gkeeth/calbox/fab/pdf/calbox-F.Fab.pdf

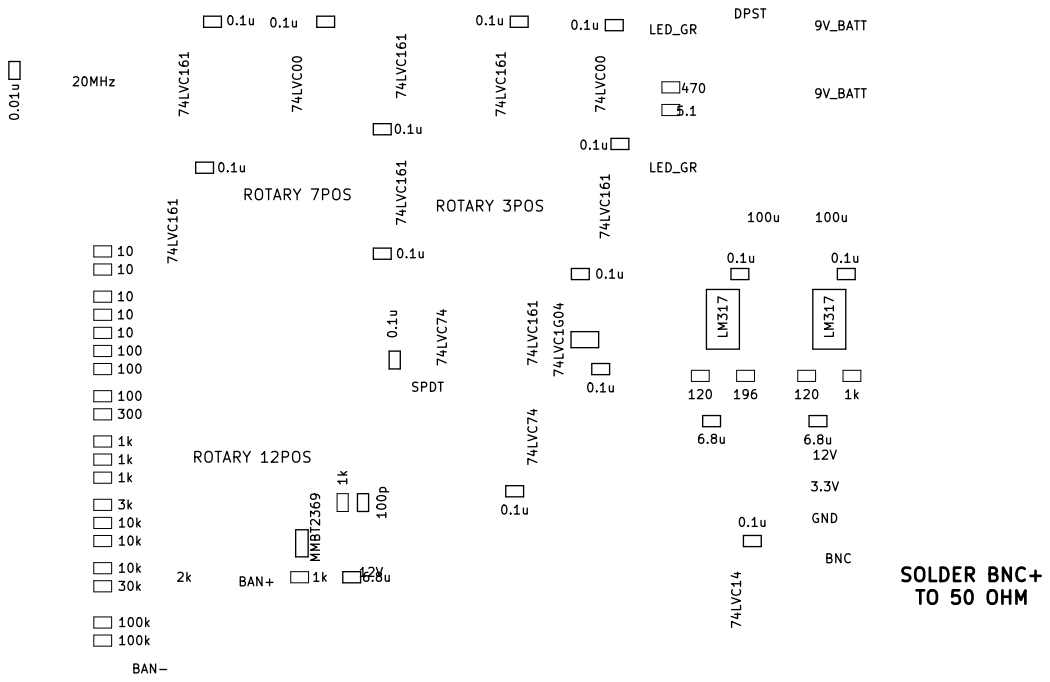
[picture p1: page 1]

File: calbox.kicad_pcb Sheet: SOLDER BNC+ TO 50 OHM
