gkeeth/calbox/doc/schem/calbox.pdf

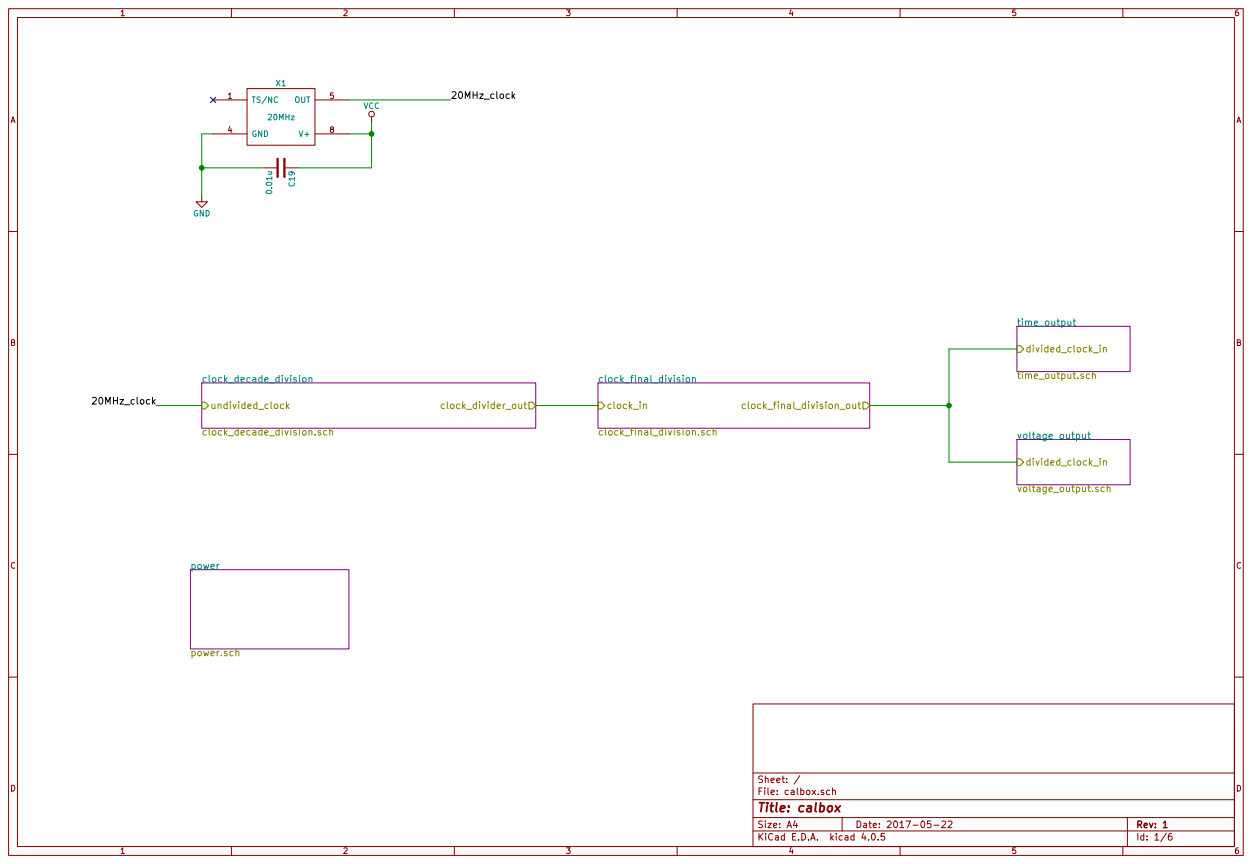
[picture p2: page 1]

File: calbox.sch Sheet: /
Id: 1/6 Title: calbox

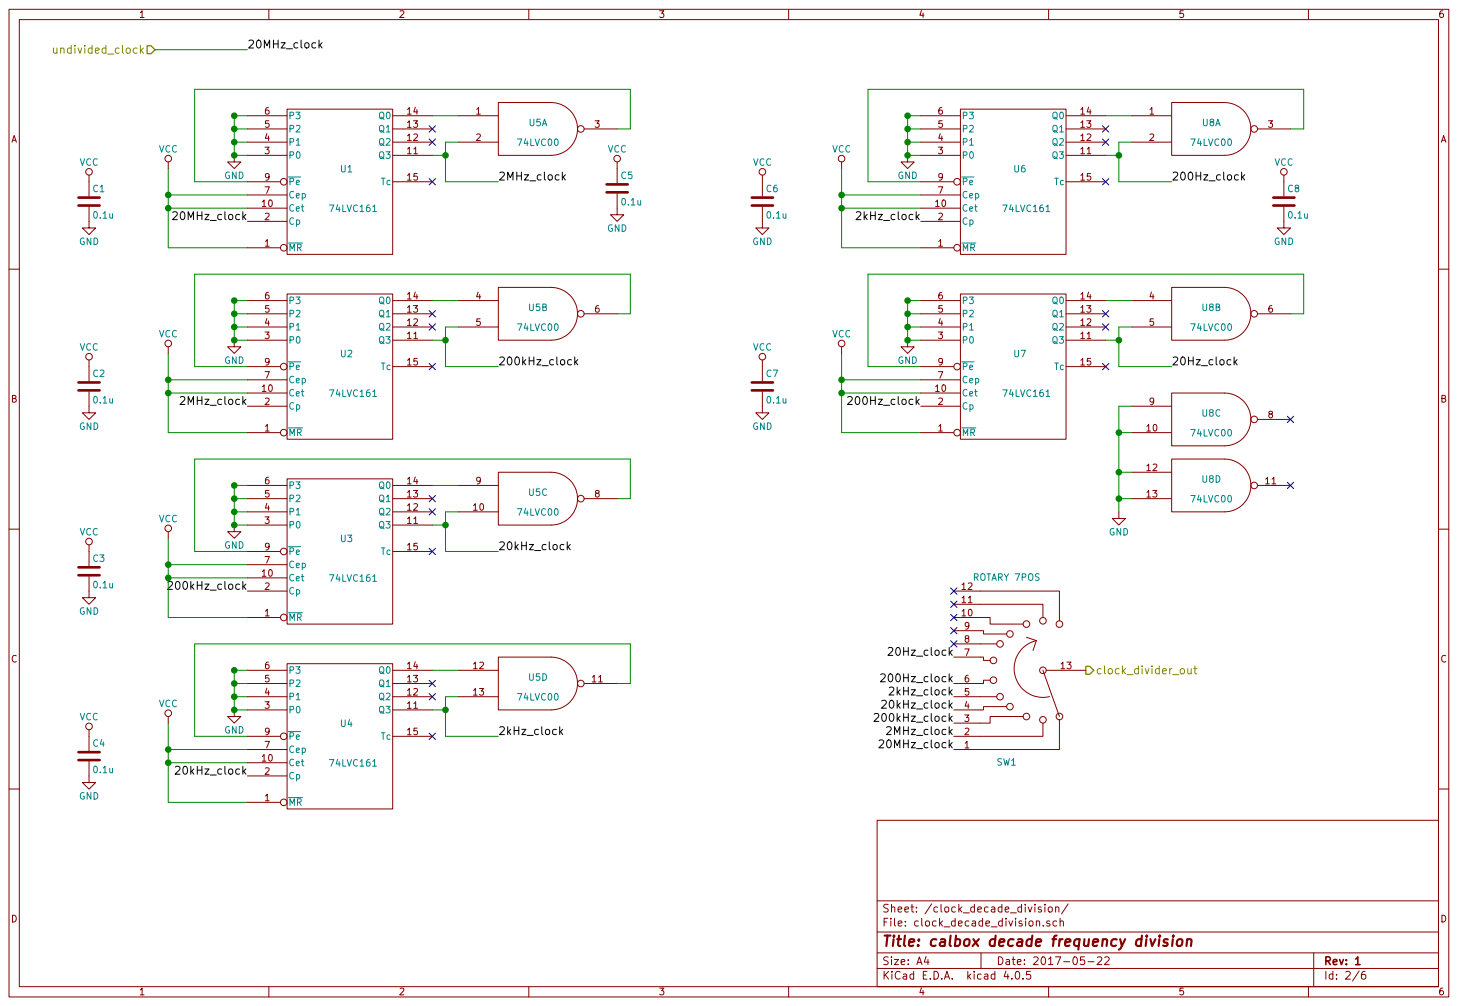
[picture p3: page 2]

Sheet: /clock_decade_division/
File: clock_decade_division.sch
Id: 2/6 Title: calbox decade frequency division

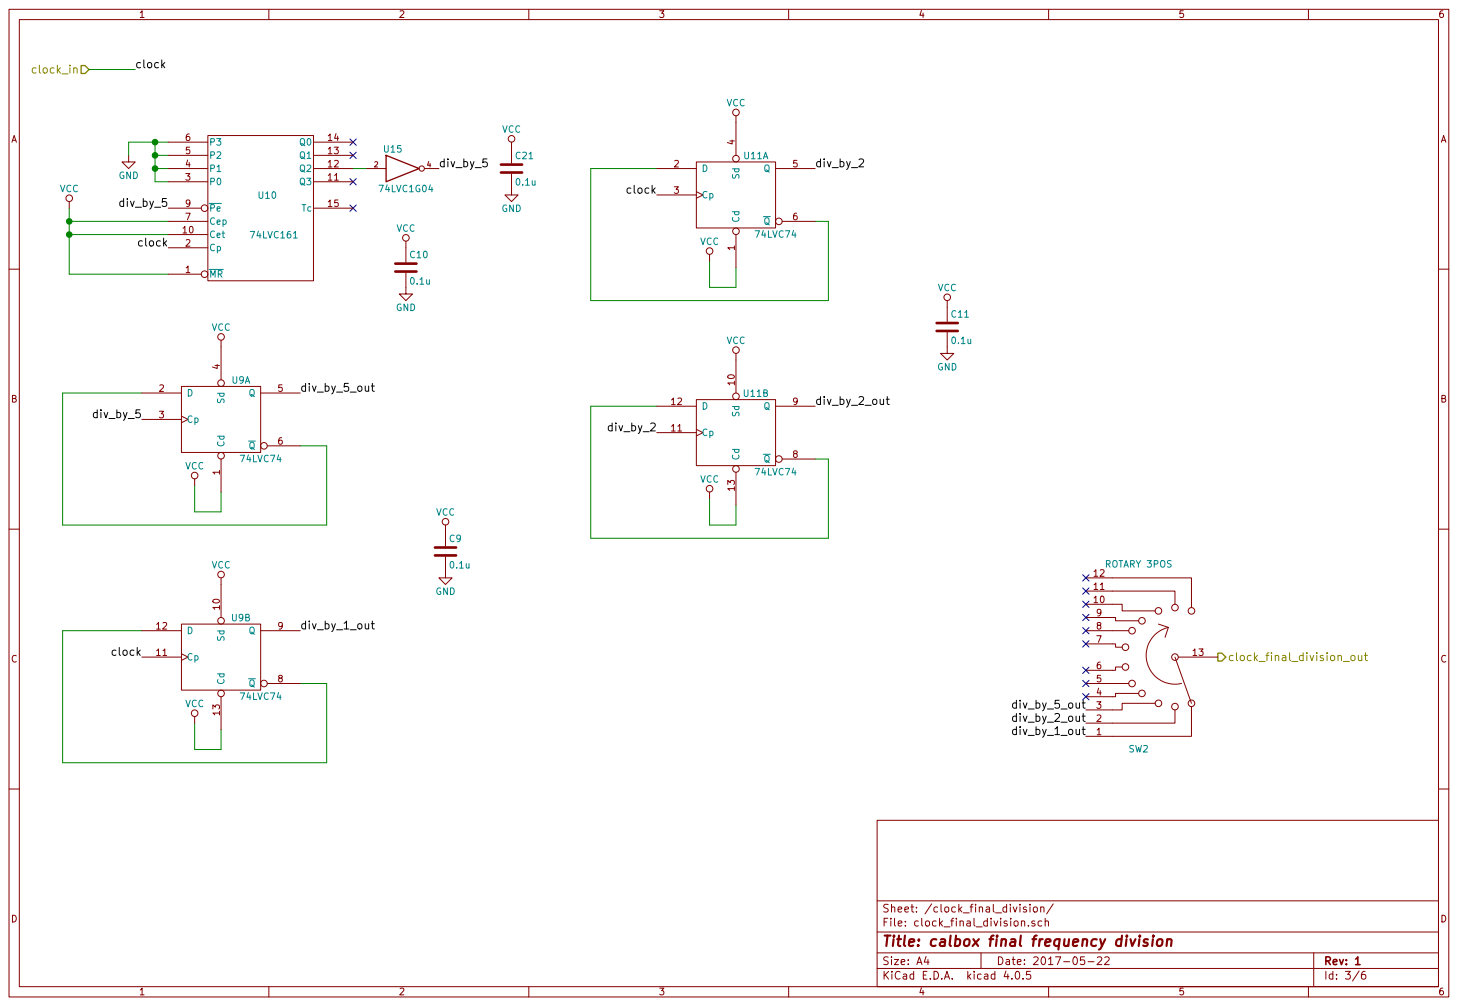
[picture p4: page 3]

Sheet: /clock_final_division/
File: clock_final_division.sch
Id: 3/6 Title: calbox final frequency division

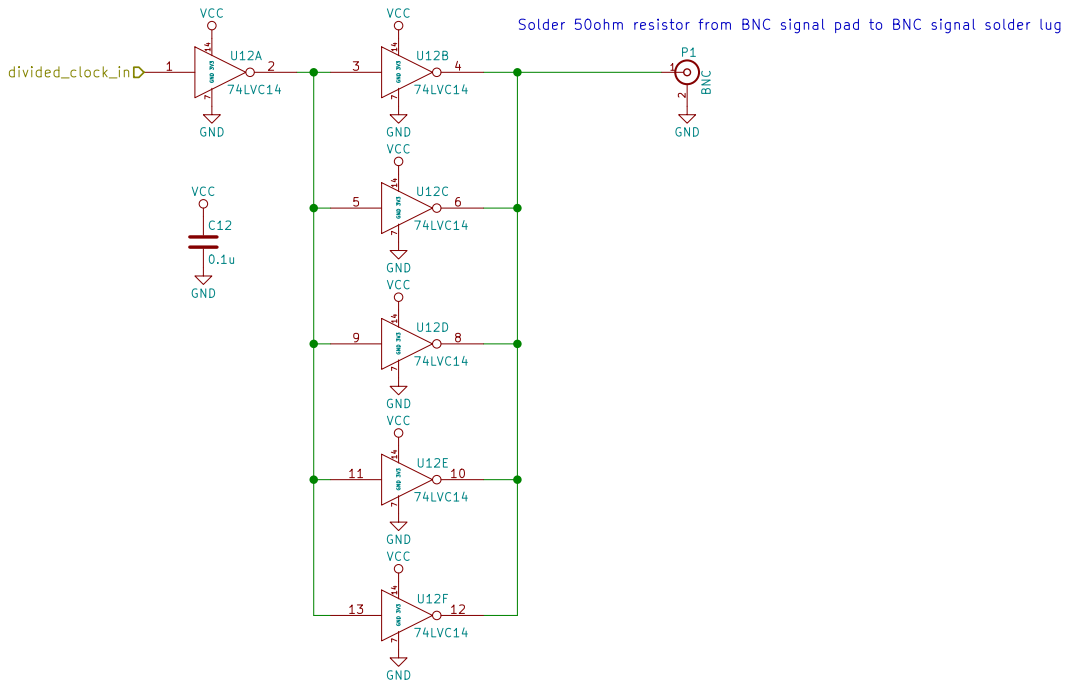
[picture p5: page 4]

Sheet: /time_output/
File: time_output.sch
Id: 4/6 Title: calbox time output

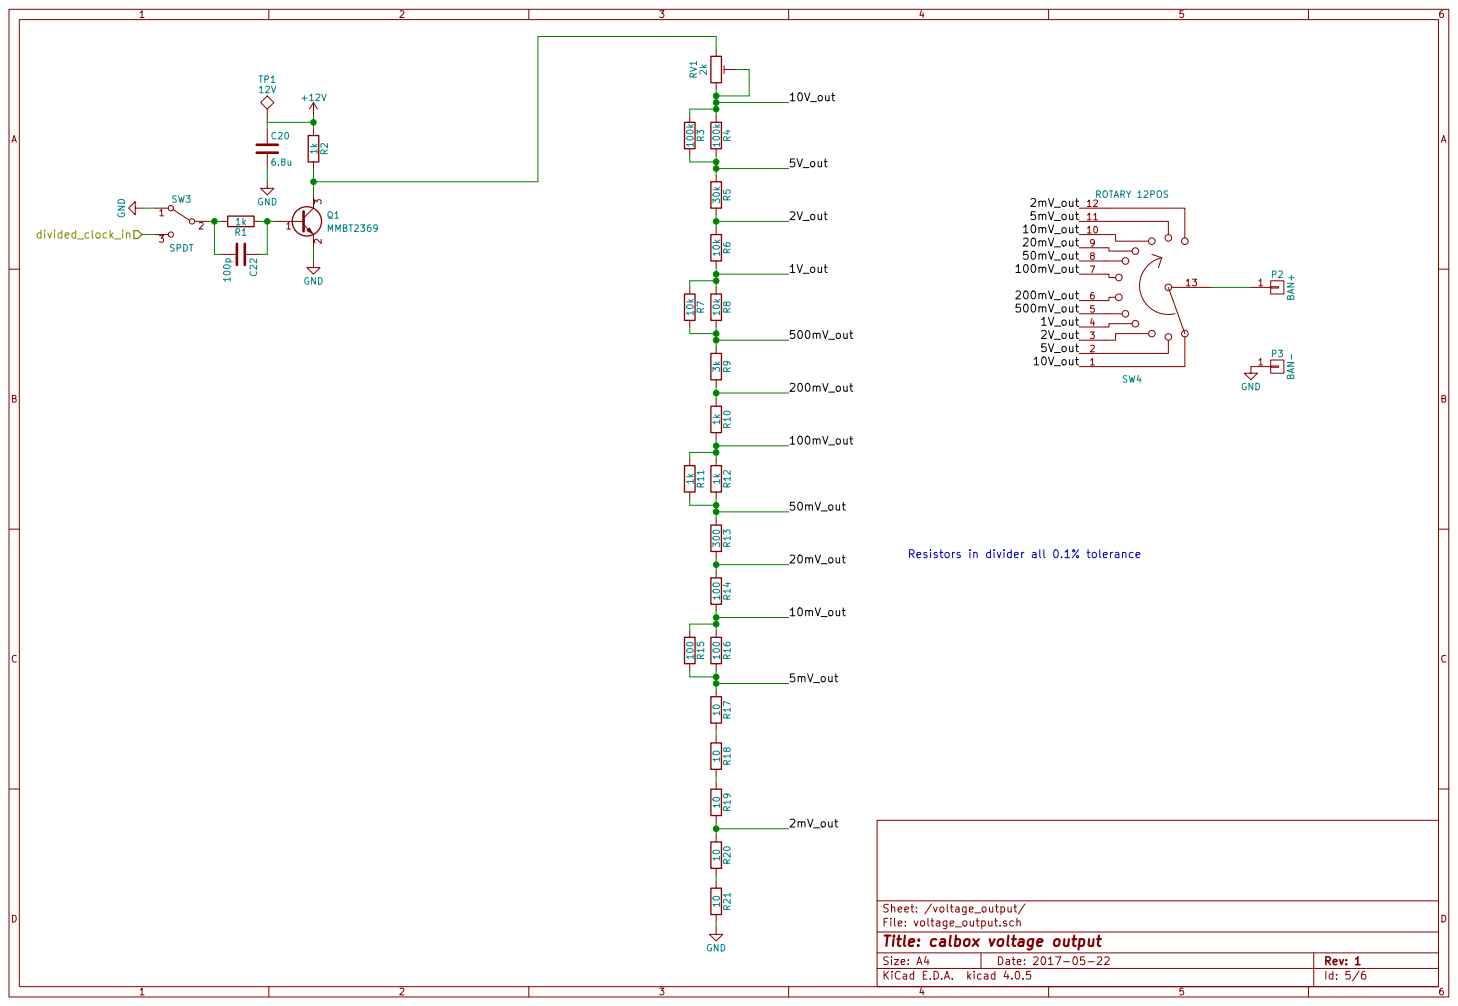
[picture p6: page 5]

File: voltage_output.sch
Id: 5/6 Title: calbox voltage output

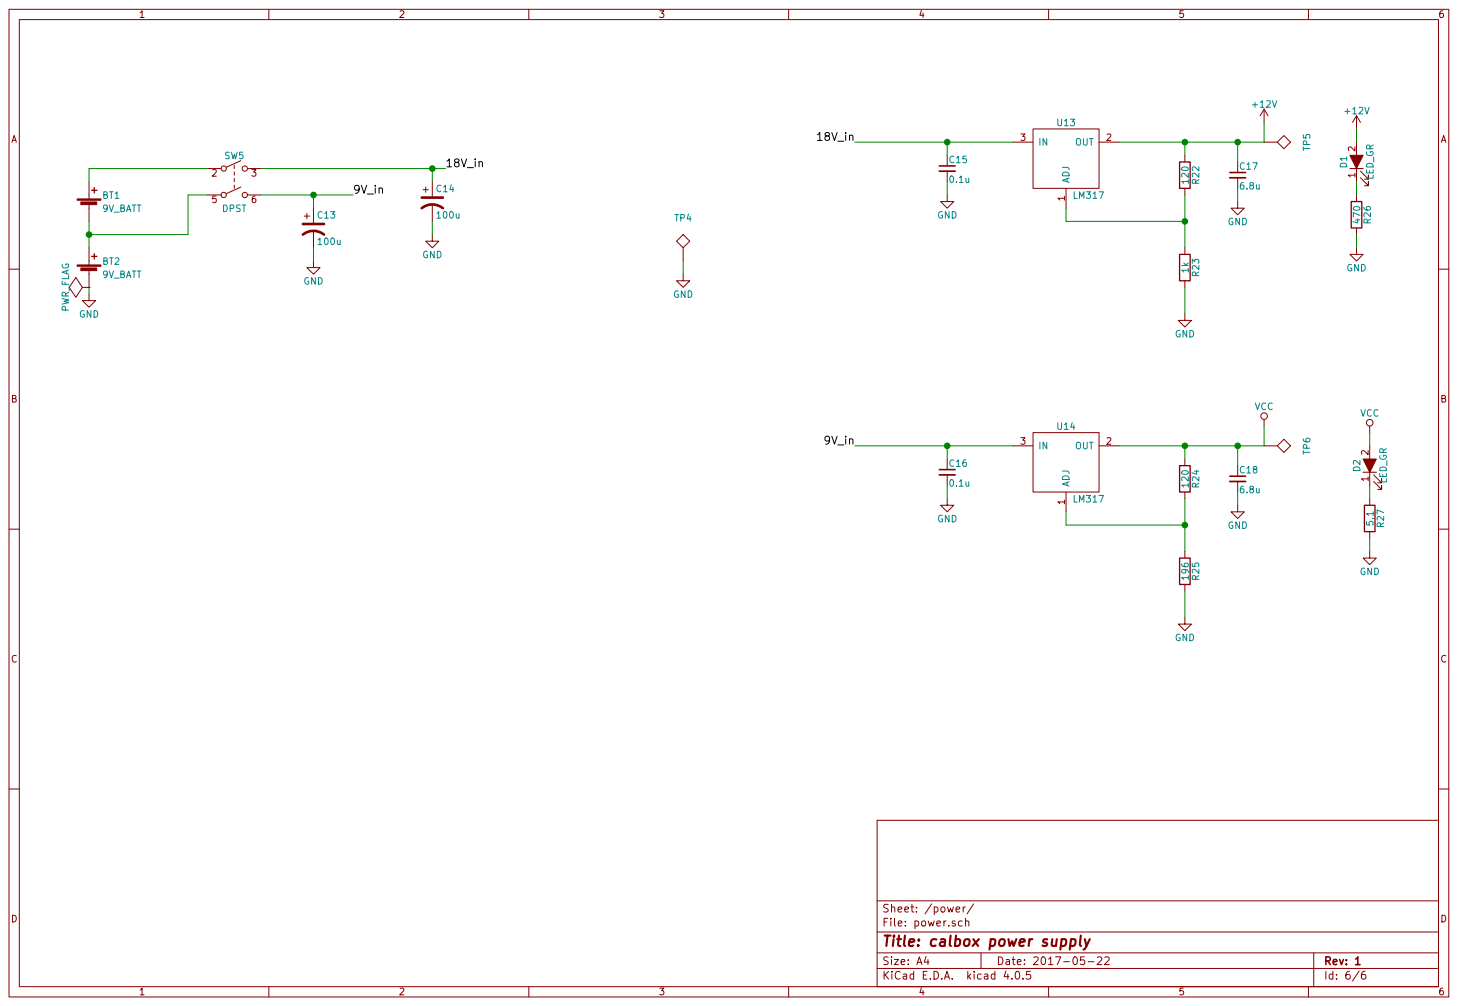
[picture p7: page 6]

Sheet: /power/
File: power.sch
Id: 6/6 Title: calbox power supply
