gkeeth/calbox/fab/pdf/calbox-B.Cu.pdf

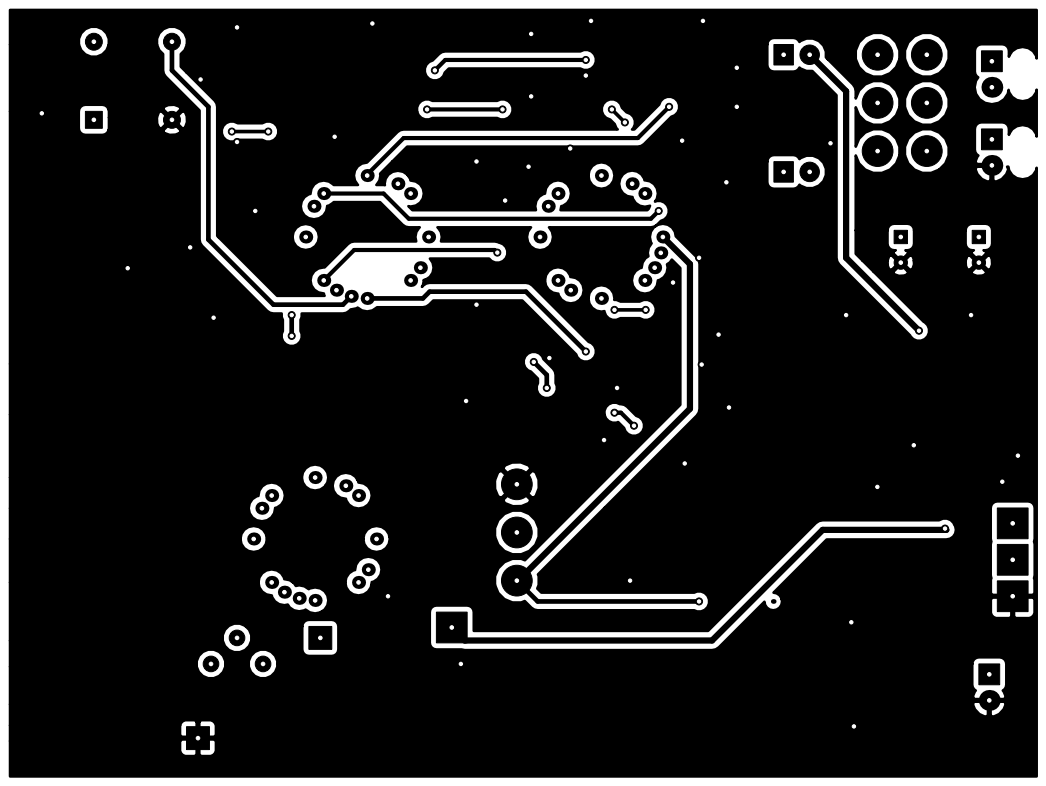
[picture p8: page 1]
