gkeeth/calbox/fab/pdf/calbox-B.Mask.pdf

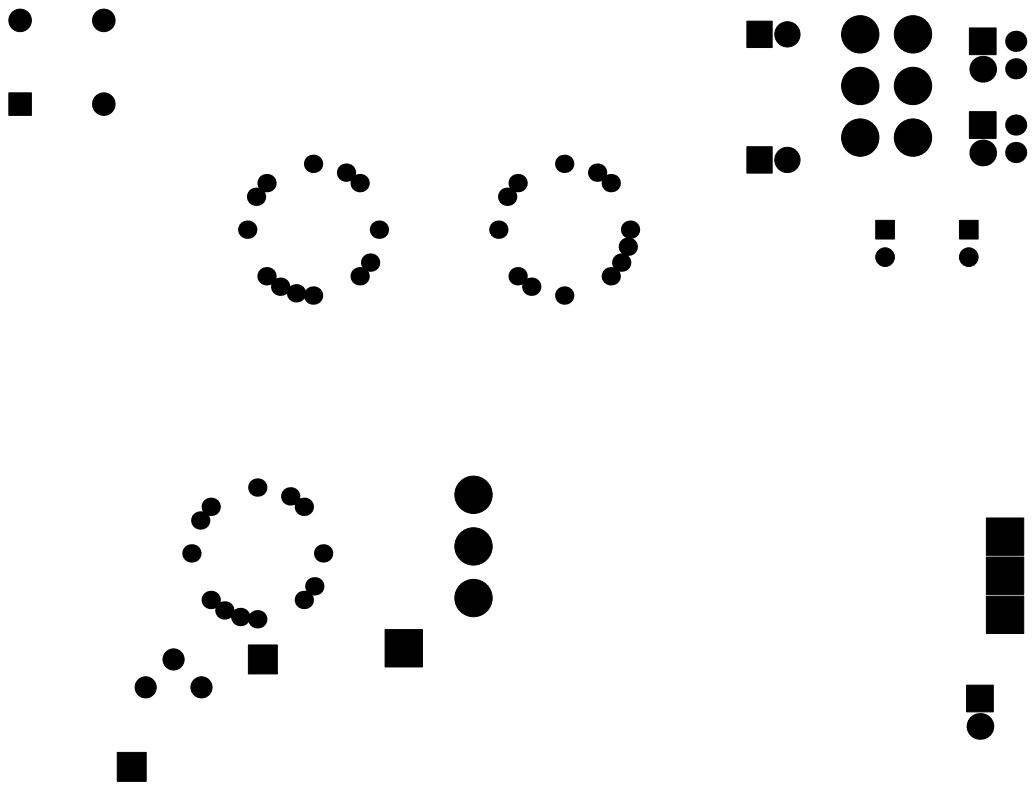
[picture p9: page 1]
