gkeeth/calbox/fab/pdf/calbox-Eco1.User.pdf

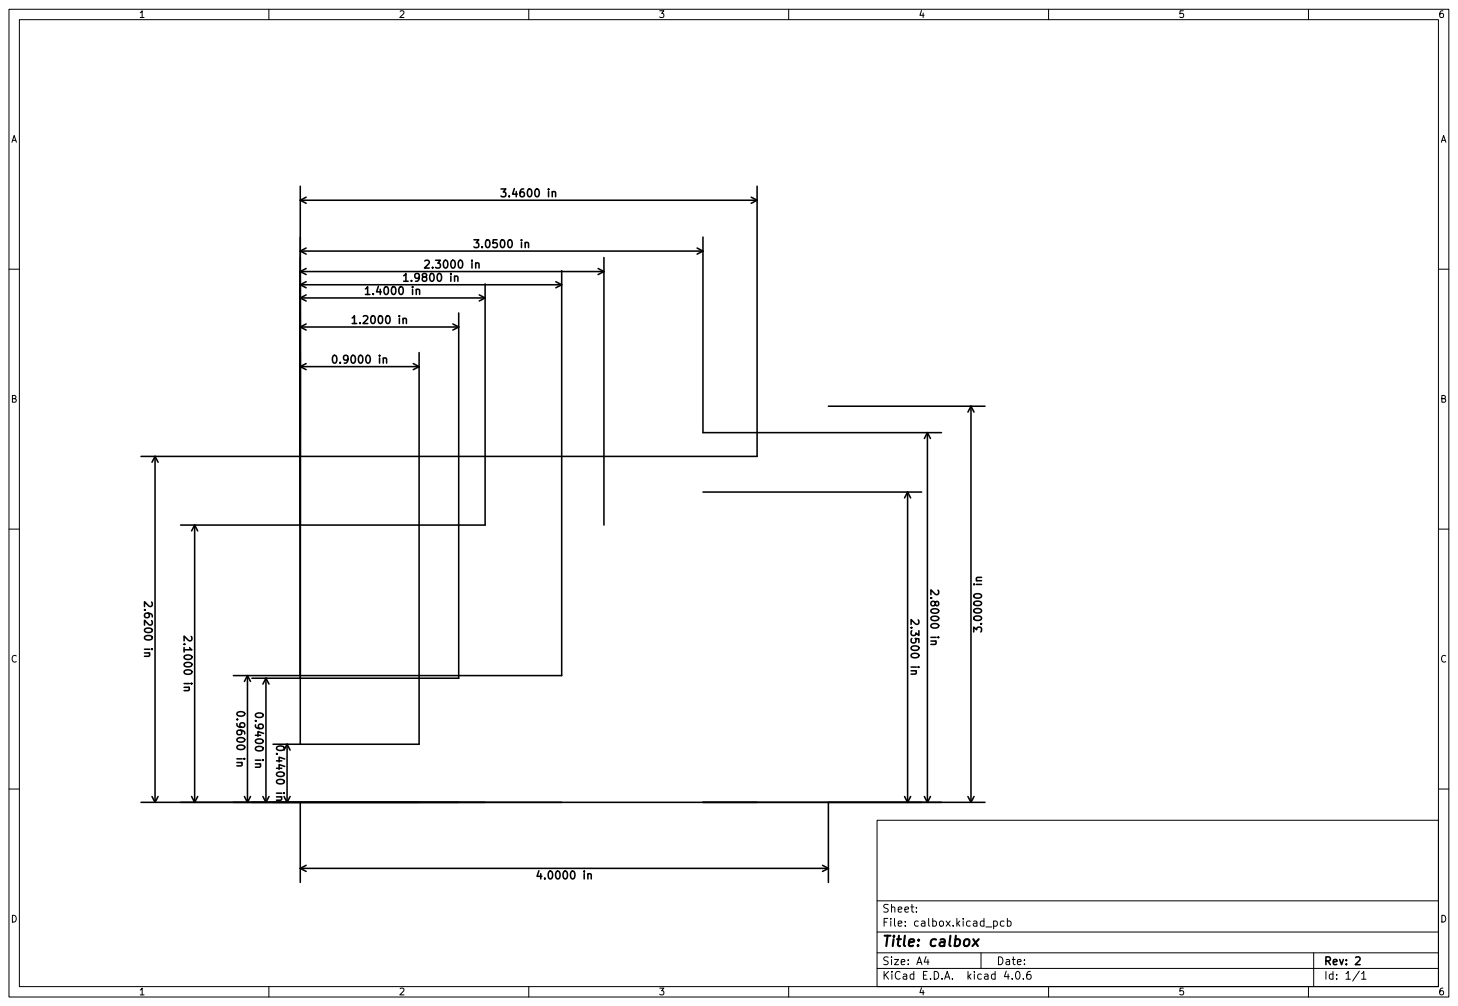
[picture p10: page 1]

1.9800 in
1.4000 in
