gkeeth/calbox/fab/pdf/calbox-Eco2.User.pdf

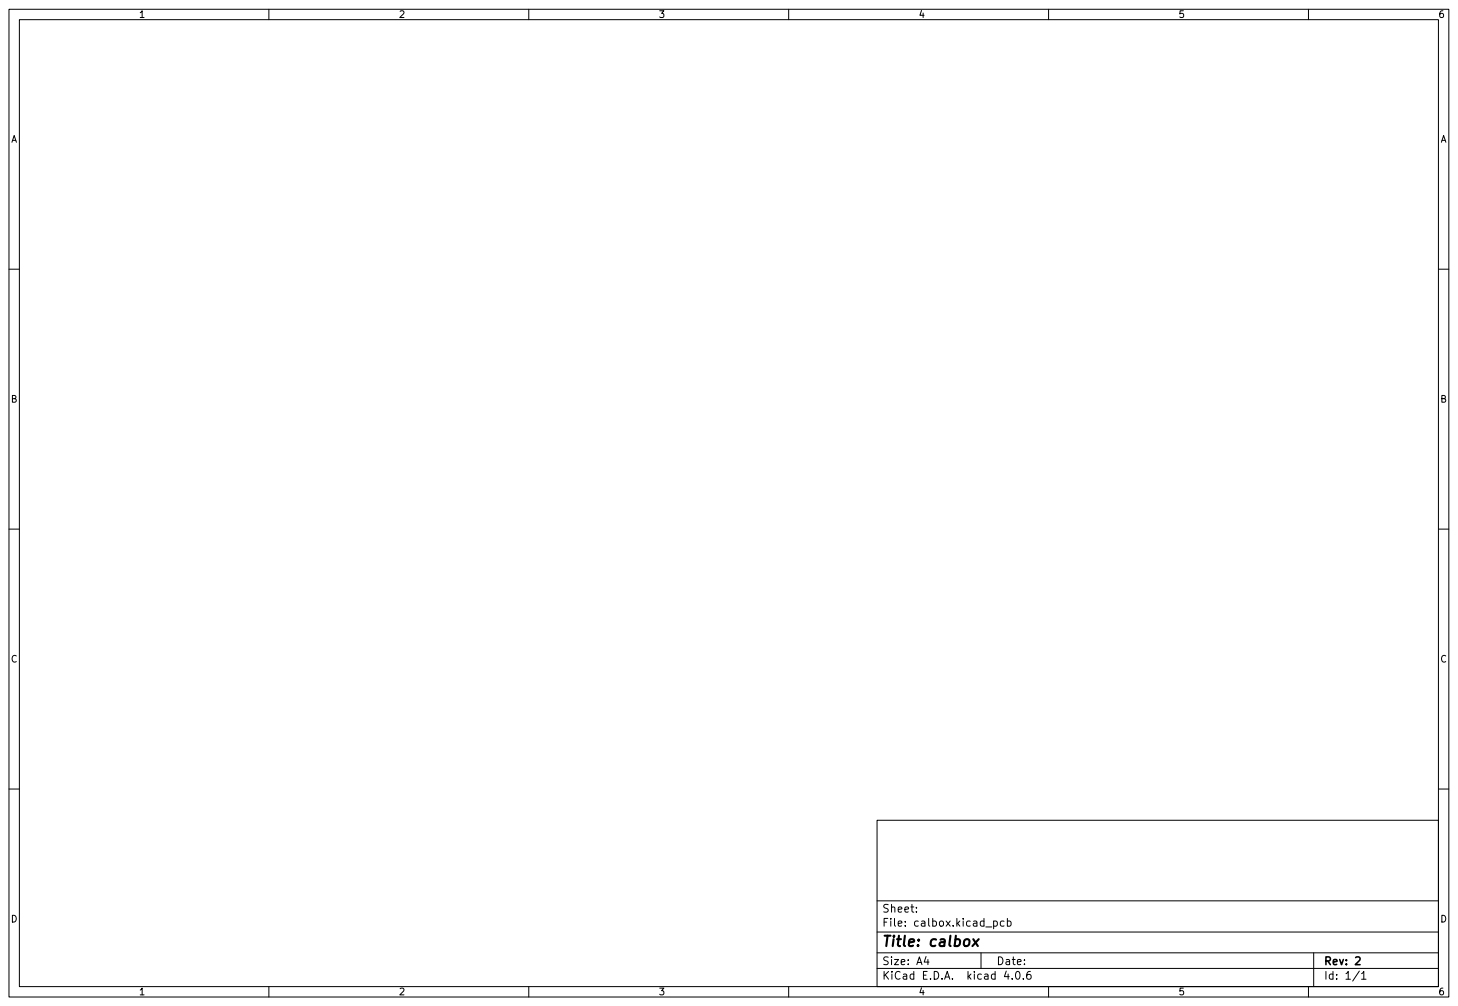
[picture p11: page 1]
