gkeeth/calbox/fab/pdf/calbox-Edge.Cuts.pdf

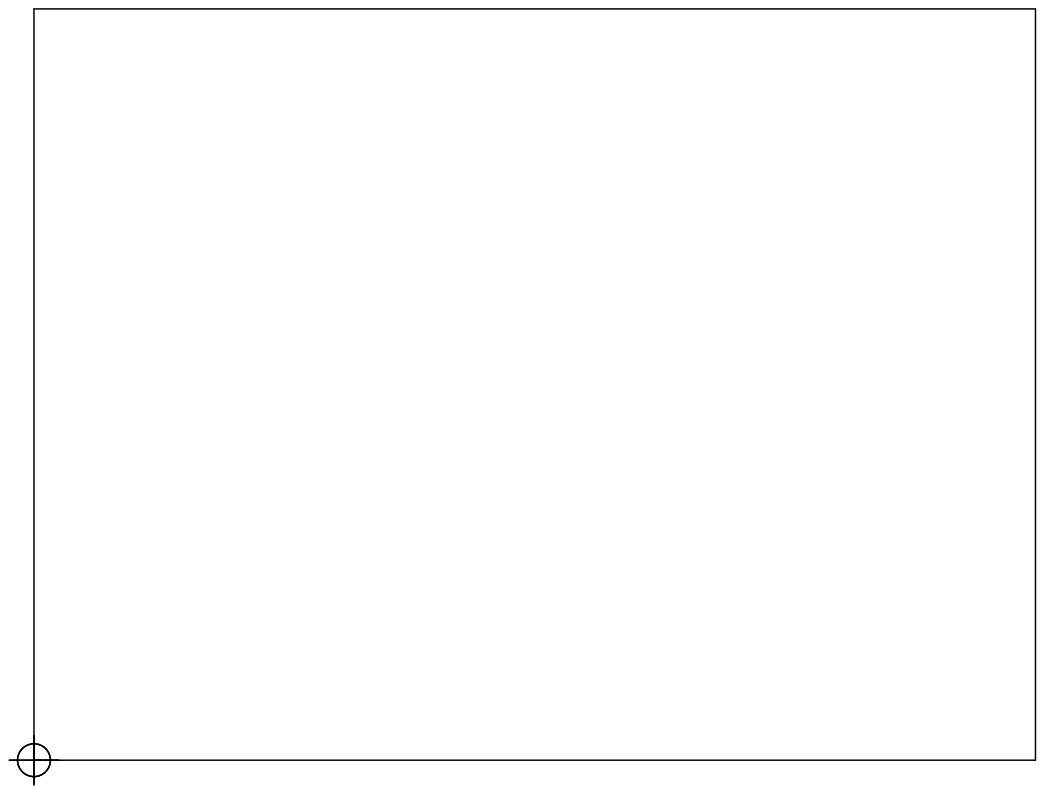
[picture p12: page 1]
