gkeeth/calbox/fab/pdf/calbox-F.Cu.pdf

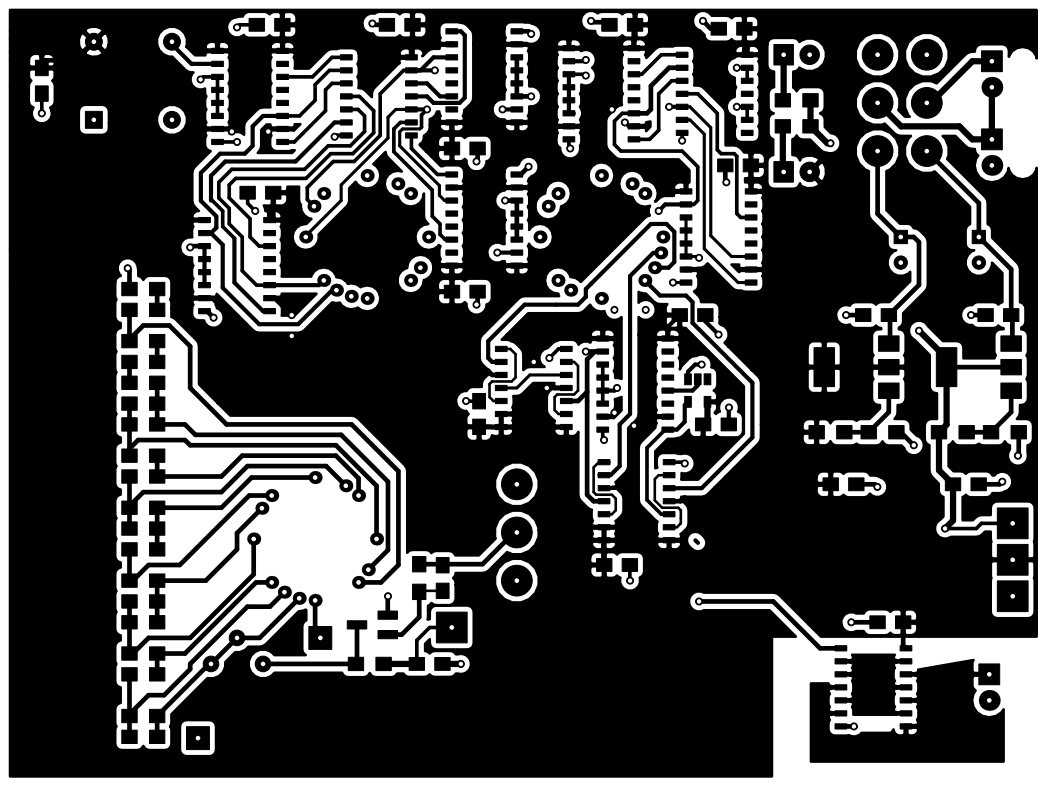
[picture p13: page 1]
