gkeeth/calbox/fab/pdf/calbox-F.Mask.pdf

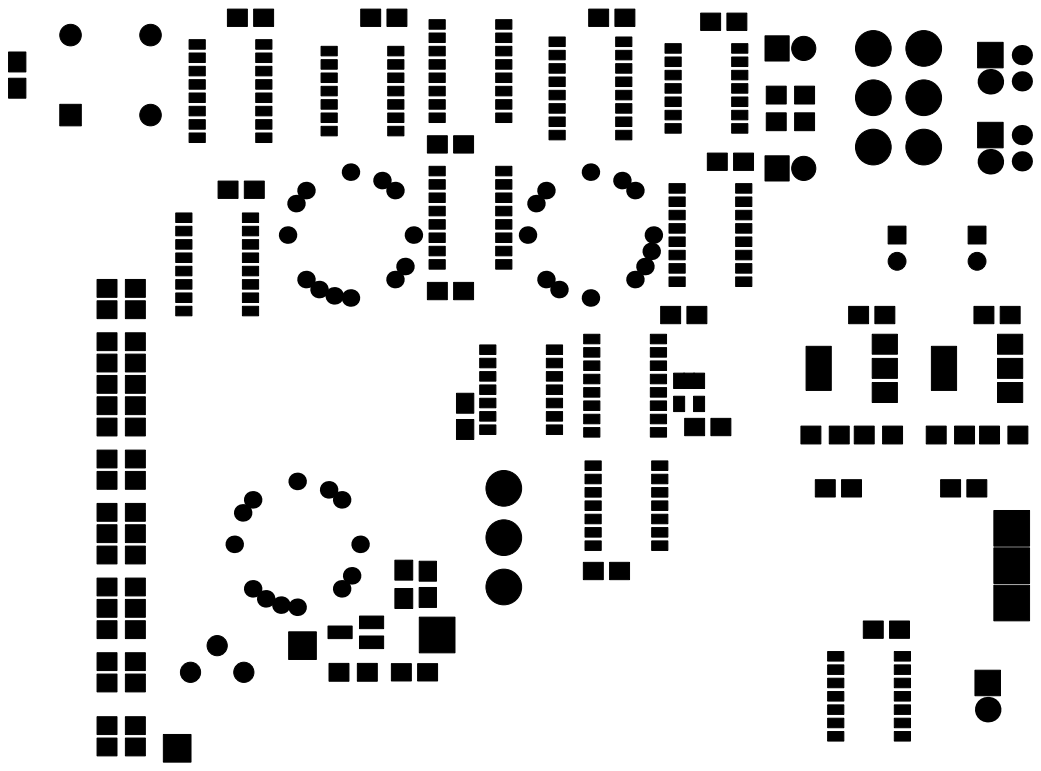
[picture p14: page 1]
