gkeeth/calbox/fab/pdf/calbox-F.SilkS.pdf

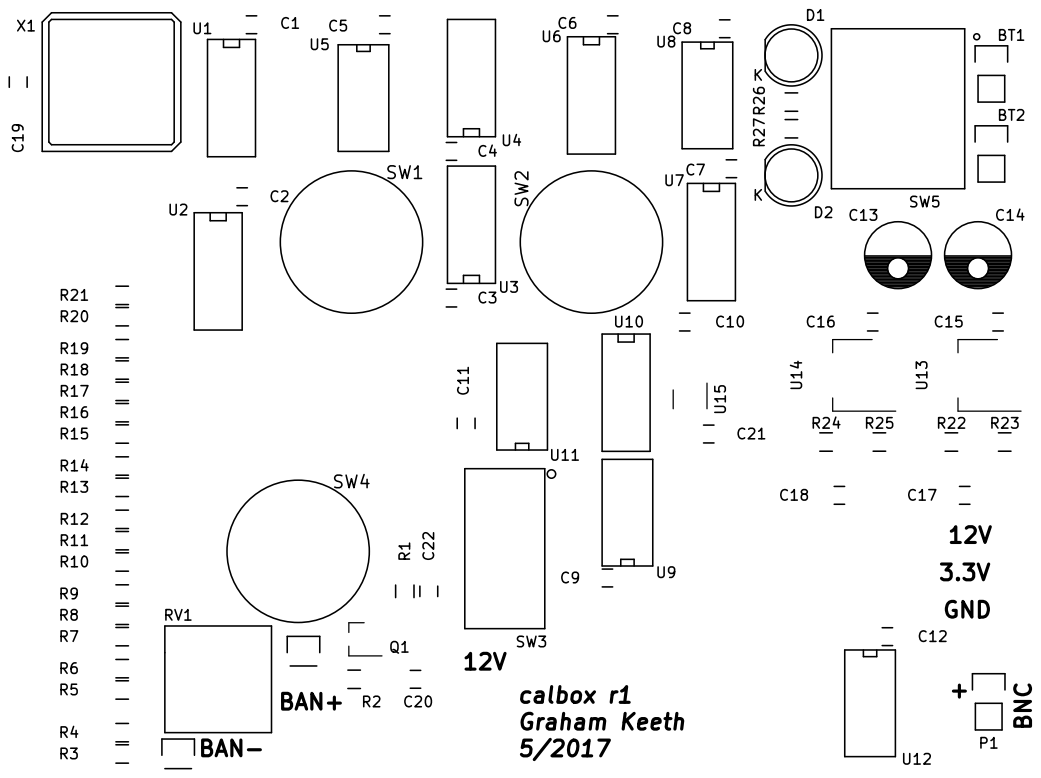
[picture p15: page 1]
