gkeeth/calbox/fab/pdf/calbox-Cmts.User.pdf

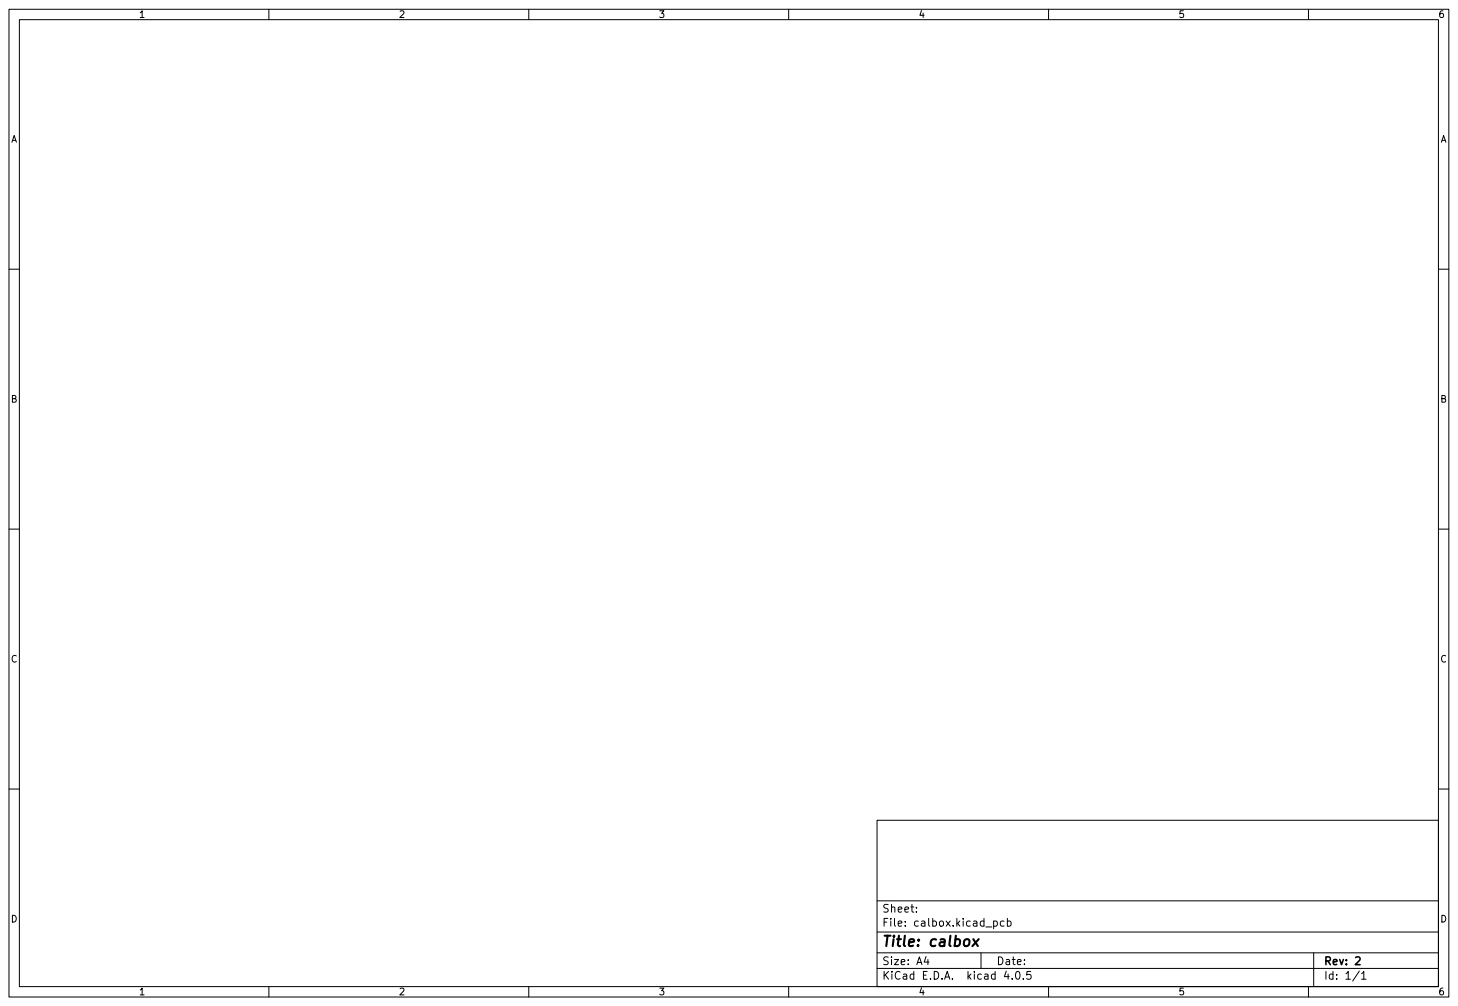
[picture p16: page 1]
