gkeeth/calbox/fab/pdf/calbox-F.CrtYd.pdf

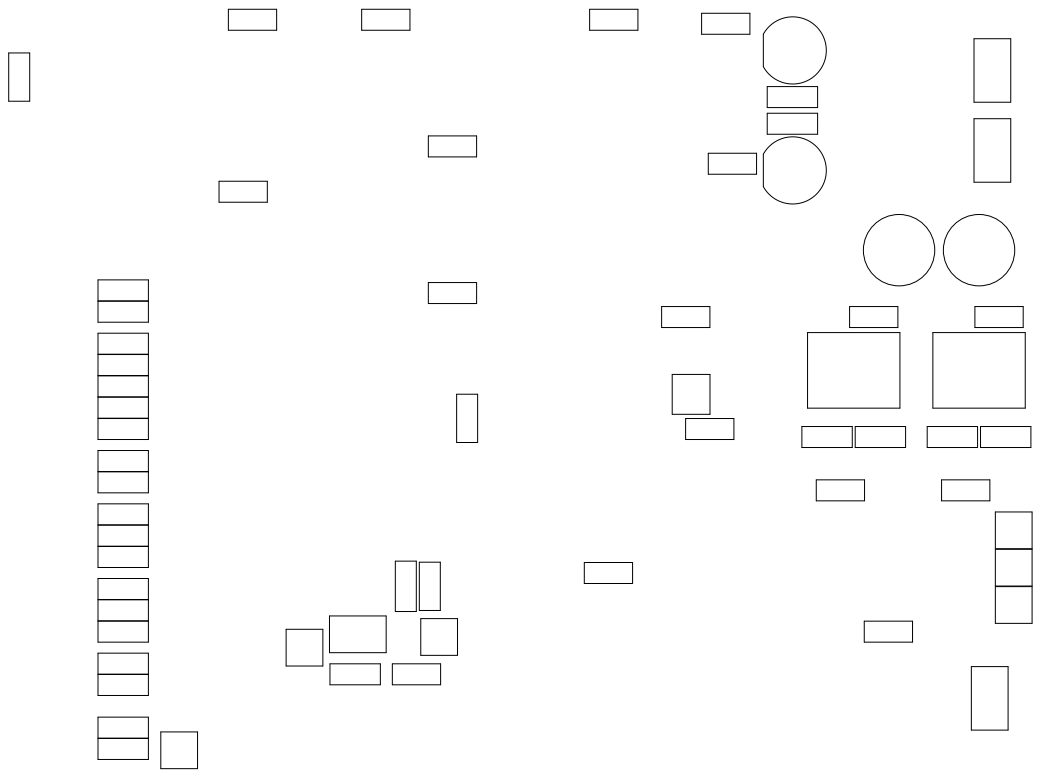
[picture p17: page 1]
