gkeeth/calbox/sim/freq_div.asc

U1: 74hct161
U2: 74hct04
V1: voltage; PULSE(0 3.3 0 1n 1n 24n 50n)
V2: voltage; 3.3
Named nets: 0, clk_20Meg, vcc, q2
.tran 10u
.inc 74hct.lib
