gkeeth/calbox/sim/voltage_output.asc

C1: cap; 6.8µ
C2: cap; 10p
C3: cap; 1p
C4: cap; 10p
C5: cap; 10p
C6: cap; 100p
C7: cap; 6.8µ
C8: cap; 100p
Q1: npn; 2N3904
Q2: npn; 2N2369
Q3: pnp; 2N3906
Q4: npn; 2N3904
Q5: npn; 2N3904
Q6: npn; 2N3904
Q7: npn; 2N3904
Q8: npn; 2N3904
Q9: npn; 2N3904
Q10: npn; 2N2369
Q11: npn; 2N3904
Q13: pnp; 2N3906
R1: res; 1k
R2: res; 50
R3: res; 30
R4: res; 10
R5: res; 5
R6: res; 3
R7: res; 2
R8: res; 1.1k
R9: res; 1k
R10: res; 1k
R11: res; 90k
R12: res; 9k
R13: res; 900
R14: res; 90
R15: res; 9
R16: res; 1
R17: res; 2.7k
R18: res; 100
R19: res; 1k
R20: res; 1k
R21: res; 90k
R22: res; 9k
R23: res; 900
R24: res; 90
R25: res; 9
R26: res; 1
R27: res; 5k
R28: res; 1k
R29: res; 1k
R30: res; 20
R31: res; 1k
R32: res; 90k
R33: res; 9k
R34: res; 900
R35: res; 90
R36: res; 9
R37: res; 1
R38: res; 2.7k
R39: res; 10k
R40: res; 470
R41: res; 90k
R42: res; 9k
R43: res; 900
R44: res; 90
R45: res; 9
R46: res; 1
R47: res; 7k
R48: res; 3k
R49: res; 1k
R50: res; 2k
R51: res; 100
R52: res; 300
R53: res; 5k
R54: res; 500
R55: res; 1k
R56: res; 3k
R57: res; 1k
R58: res; 1.1k
R59: res; 1k
R60: res; 100k
V1: voltage; 12.19
V2: voltage; PULSE(0 3.3 0 10n 10n 40n 100n)
V3: voltage; 16
V4: voltage; 16
V5: voltage; 16
V6: voltage; 16
V7: voltage; 12.19
Named nets: 0, clk, pushpull_out, 10V, schmitt_out, comparator_out, highside_out, 5V, 2V, 2mV, 5mV, 10mV, 20mV, 50mV, 100mV, 200mV, 500mV, 1V, 10V2
.tran 1300n
.step param CC list 1p 10p 100p 1n 10n
.step param RB list 100 500 1k 5k 10k
.step dec param Cspeedup 1p 1n 2
.step param Rbase list 10 50 100 500 1k
