gkeeth/calbox/calbox.kicad_pcb

## KiCad design calbox.kicad_pcb (2017-05-23)

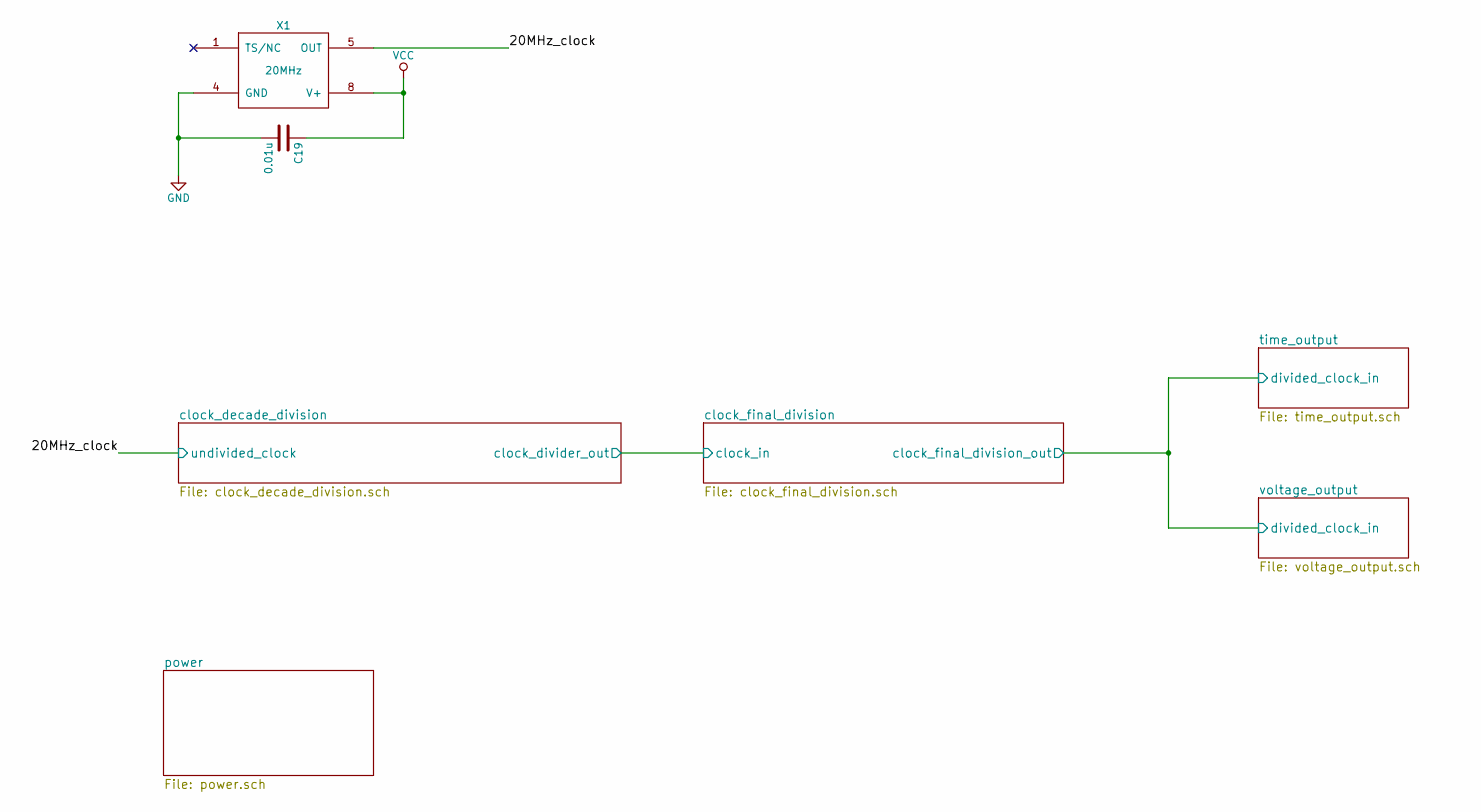
[picture p18: schematic calbox.sch]

Parts:
C19: 0.01u; C_0805_HandSoldering
X1: 20MHz; OSC_DIP8; Manufacturer PN ACHL-20.000MHZ-EK

Connections:
/20MHz_clock: X1.5 (OUT); also elsewhere on the board
GND: C19.2, X1.4 (GND); also elsewhere on the board
VCC: C19.1, X1.8 (V+); also elsewhere on the board

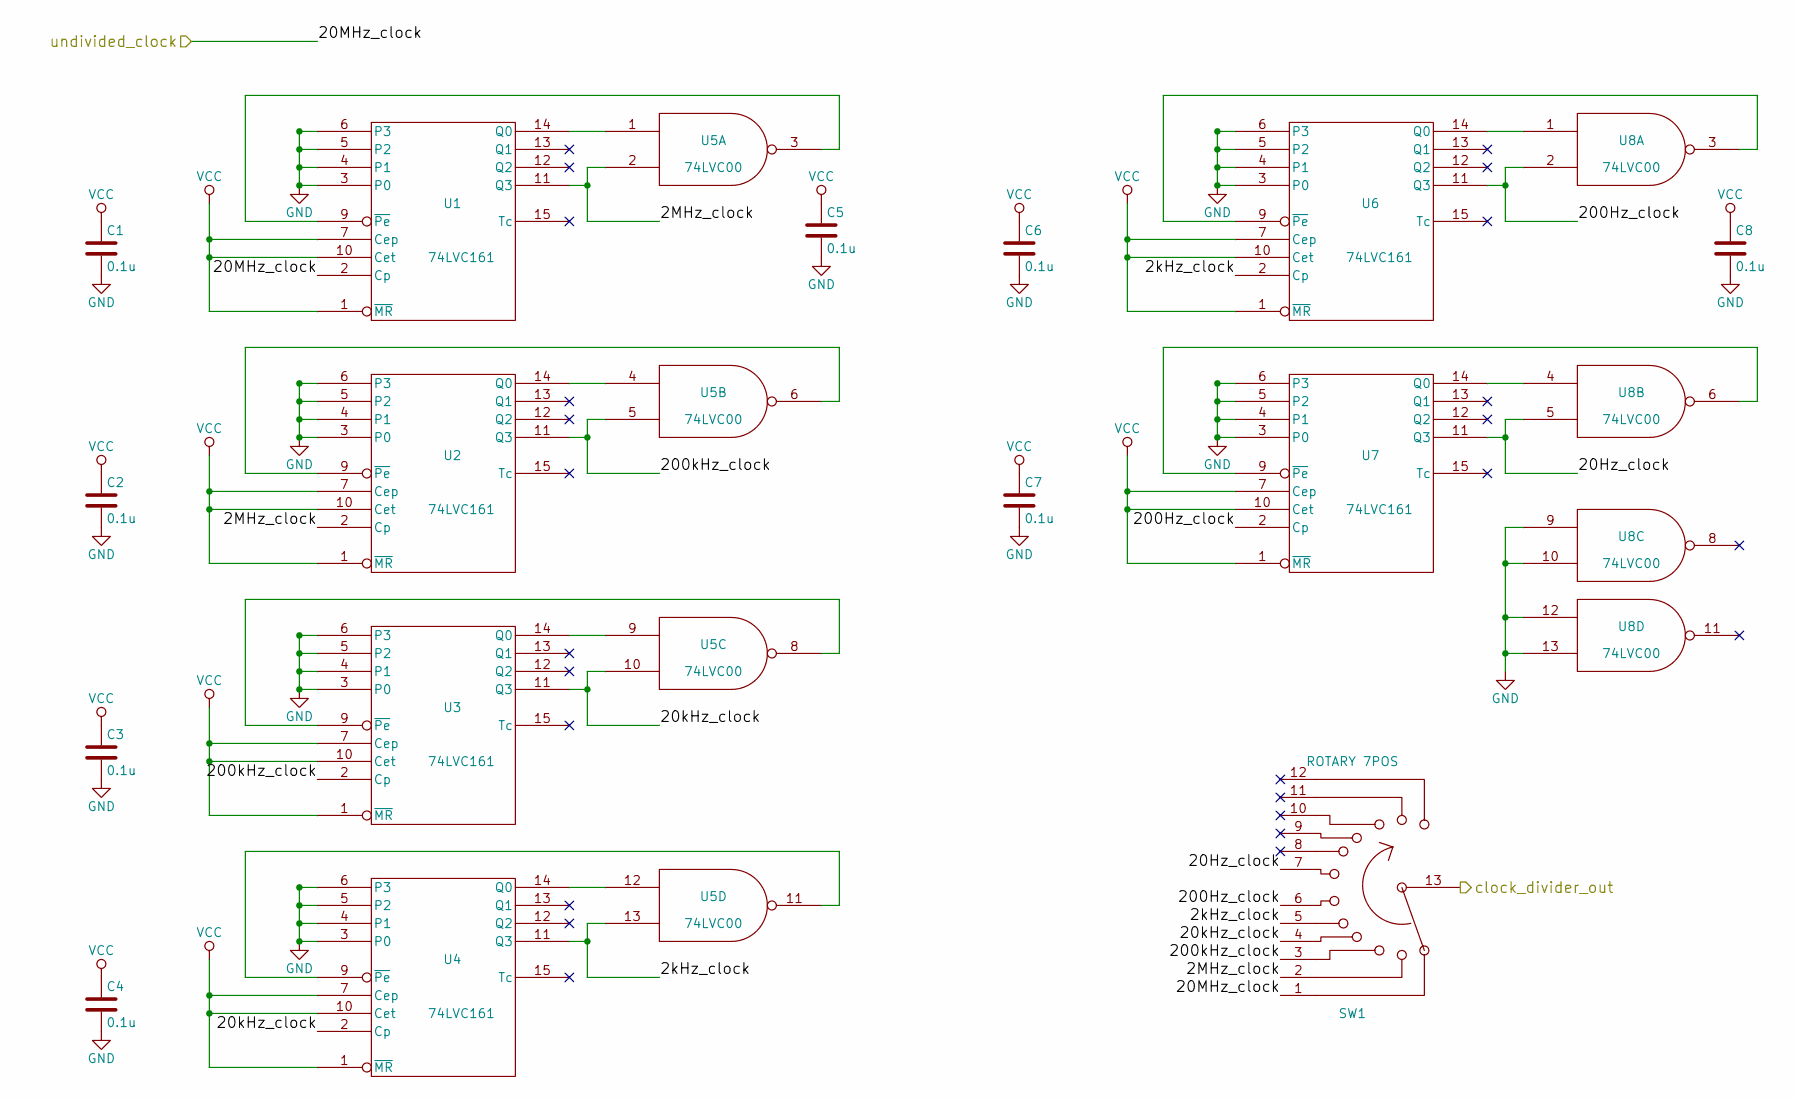
[picture p19: schematic clock_decade_division.sch, calbox decade frequency division]

Parts:
C1, C2, C3, C4, C5, C6, C7, C8: 0.1u; C_0805_HandSoldering
SW1: ROTARY 7POS; SW_ROTARY_SP12T_MRK112; Manufacturer PN MRK112-A
U1, U2, U3, U4, U6, U7: 74LVC161; SO-16-N; Manufacturer PN 4LVC161D118
U5, U8: 74LVC00; SOIC-14_N; Manufacturer PN SN74LVC00ADR

Connections:
/20MHz_clock: SW1.1, U1.2 (Cp); also elsewhere on the board
/clock_decade_division/2MHz_clock: SW1.2, U1.11 (Q3), U2.2 (Cp), U5.2
/clock_decade_division/2kHz_clock: SW1.5, U4.11 (Q3), U5.13, U6.2 (Cp)
/clock_decade_division/20Hz_clock: SW1.7, U7.11 (Q3), U8.5
/clock_decade_division/20kHz_clock: SW1.4, U3.11 (Q3), U4.2 (Cp), U5.10
/clock_decade_division/200Hz_clock: SW1.6, U6.11 (Q3), U7.2 (Cp), U8.2
/clock_decade_division/200kHz_clock: SW1.3, U2.11 (Q3), U3.2 (Cp), U5.5
/clock_decade_division/clock_divider_out: SW1.13; also elsewhere on the board
GND: C1.2, C2.2, C3.2, C4.2, C5.2, C6.2, C7.2, C8.2, U1.3 (P0), U1.4 (P1), U1.5 (P2), U1.6 (P3), U1.8 (GND), U2.3 (P0), U2.4 (P1), U2.5 (P2), U2.6 (P3), U2.8 (GND), U3.3 (P0), U3.4 (P1), U3.5 (P2), U3.6 (P3), U3.8 (GND), U4.3 (P0), U4.4 (P1), U4.5 (P2), U4.6 (P3), U4.8 (GND), U5.7 (GND), U6.3 (P0), U6.4 (P1), U6.5 (P2), U6.6 (P3), U6.8 (GND), U7.3 (P0), U7.4 (P1), U7.5 (P2), U7.6 (P3), U7.8 (GND), U8.7 (GND), U8.9, U8.10, U8.12, U8.13; also elsewhere on the board
unnamed: U1.9 (~Pe), U5.3
unnamed: U1.14 (Q0), U5.1
unnamed: U2.9 (~Pe), U5.6
unnamed: U2.14 (Q0), U5.4
unnamed: U3.9 (~Pe), U5.8
unnamed: U3.14 (Q0), U5.9
unnamed: U4.9 (~Pe), U5.11
unnamed: U4.14 (Q0), U5.12
unnamed: U6.9 (~Pe), U8.3
unnamed: U6.14 (Q0), U8.1
unnamed: U7.9 (~Pe), U8.6
unnamed: U7.14 (Q0), U8.4
VCC: C1.1, C2.1, C3.1, C4.1, C5.1, C6.1, C7.1, C8.1, U1.1 (~MR), U1.7 (Cep), U1.10 (Cet), U1.16 (VCC), U2.1 (~MR), U2.7 (Cep), U2.10 (Cet), U2.16 (VCC), U3.1 (~MR), U3.7 (Cep), U3.10 (Cet), U3.16 (VCC), U4.1 (~MR), U4.7 (Cep), U4.10 (Cet), U4.16 (VCC), U5.14 (VCC), U6.1 (~MR), U6.7 (Cep), U6.10 (Cet), U6.16 (VCC), U7.1 (~MR), U7.7 (Cep), U7.10 (Cet), U7.16 (VCC), U8.14 (VCC); also elsewhere on the board

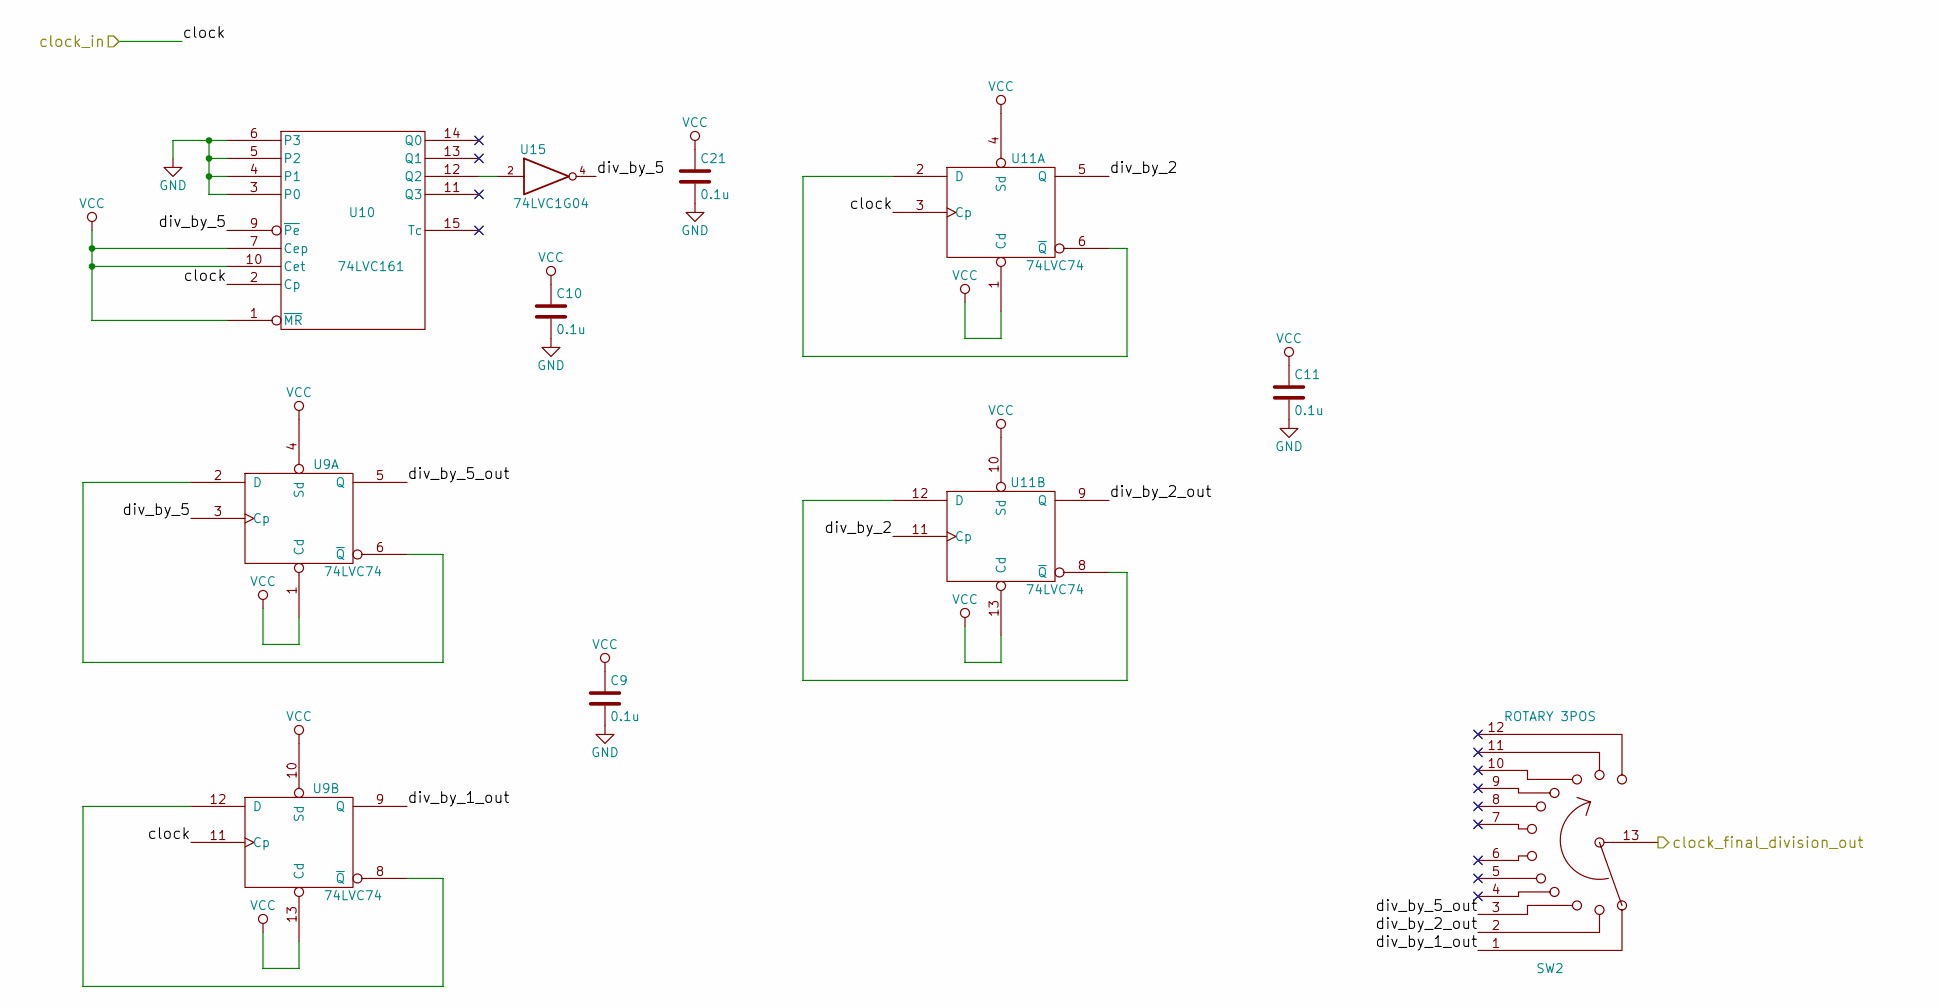
[picture p20: schematic clock_final_division.sch, calbox final frequency division]

Parts:
C9, C10, C11, C21: 0.1u; C_0805_HandSoldering
SW2: ROTARY 3POS; SW_ROTARY_SP12T_MRK112; Manufacturer PN MRK112-A
U9, U11: 74LVC74; SOIC-14_N; Manufacturer PN SN74LVC74ADR
U10: 74LVC161; SO-16-N; Manufacturer PN 4LVC161D118
U15: 74LVC1G04; SOT-23-5

Connections:
/clock_decade_division/clock_divider_out: U9.11 (Cp), U10.2 (Cp), U11.3 (Cp); also elsewhere on the board
/clock_final_division/clock_final_division_out: SW2.13; also elsewhere on the board
/clock_final_division/div_by_1_out: SW2.1, U9.9 (Q)
/clock_final_division/div_by_2: U11.5 (Q), U11.11 (Cp)
/clock_final_division/div_by_2_out: SW2.2, U11.9 (Q)
/clock_final_division/div_by_5: U9.3 (Cp), U10.9 (~Pe), U15.4
/clock_final_division/div_by_5_out: SW2.3, U9.5 (Q)
GND: C9.2, C10.2, C11.2, C21.2, U9.7 (GND), U10.3 (P0), U10.4 (P1), U10.5 (P2), U10.6 (P3), U10.8 (GND), U11.7 (GND), U15.3 (GND); also elsewhere on the board
unnamed: U9.2 (D), U9.6 (~Q)
unnamed: U9.8 (~Q), U9.12 (D)
unnamed: U10.12 (Q2), U15.2
unnamed: U11.2 (D), U11.6 (~Q)
unnamed: U11.8 (~Q), U11.12 (D)
VCC: C9.1, C10.1, C11.1, C21.1, U9.1 (Cd), U9.4 (Sd), U9.10 (Sd), U9.13 (Cd), U9.14 (VCC), U10.1 (~MR), U10.7 (Cep), U10.10 (Cet), U10.16 (VCC), U11.1 (Cd), U11.4 (Sd), U11.10 (Sd), U11.13 (Cd), U11.14 (VCC), U15.5 (VCC); also elsewhere on the board

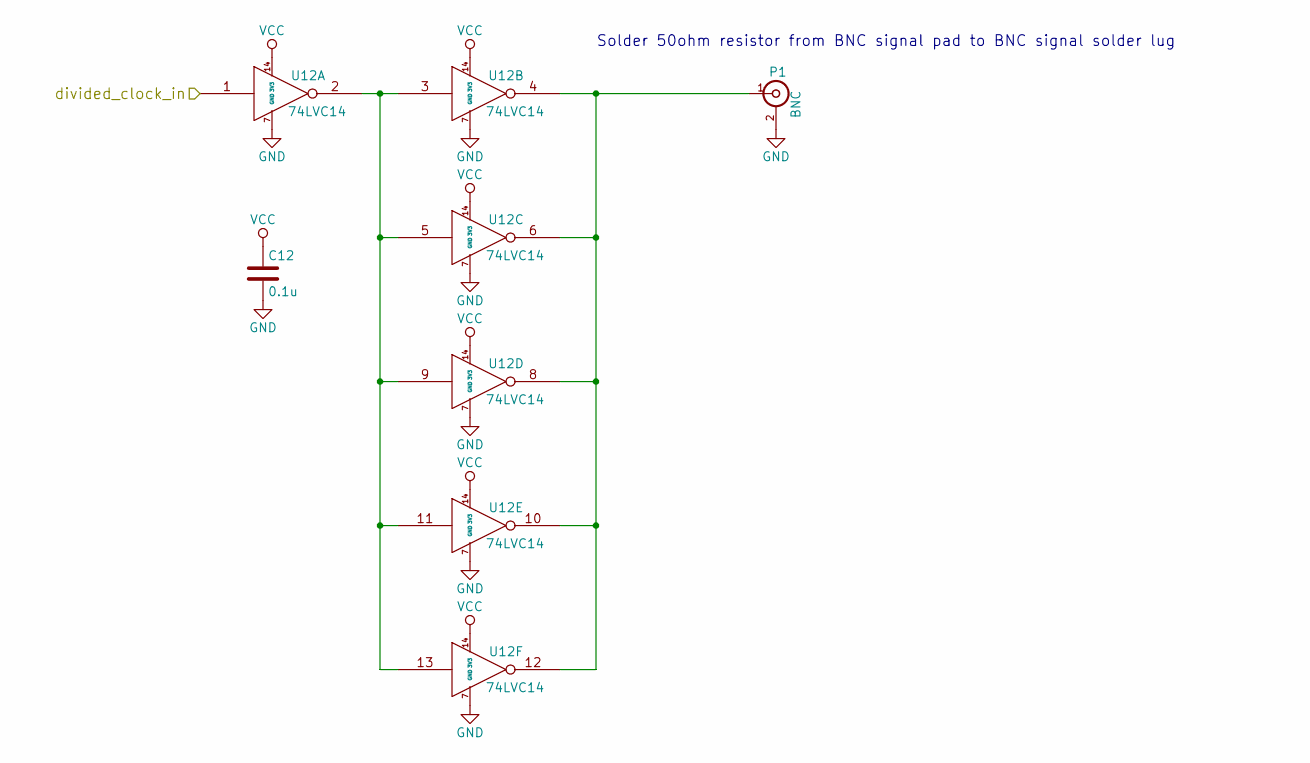
[picture p21: schematic time_output.sch, calbox time output]

Parts:
C12: 0.1u; C_0805_HandSoldering
P1: BNC; Pin_Header_Straight_1x02
U12: 74LVC14; SOIC-14_N; Manufacturer PN SN74LVC14ADR

Connections:
/clock_final_division/clock_final_division_out: U12.1; also elsewhere on the board
GND: C12.2, P1.2 (Ext), U12.7 (GND); also elsewhere on the board
unnamed: P1.1 (In), U12.4, U12.6, U12.8, U12.10, U12.12
unnamed: U12.2, U12.3, U12.5, U12.9, U12.11, U12.13
VCC: C12.1, U12.14 (3V3); also elsewhere on the board

Notes on the sheet:
Solder 50ohm resistor from BNC signal pad to BNC signal solder lug

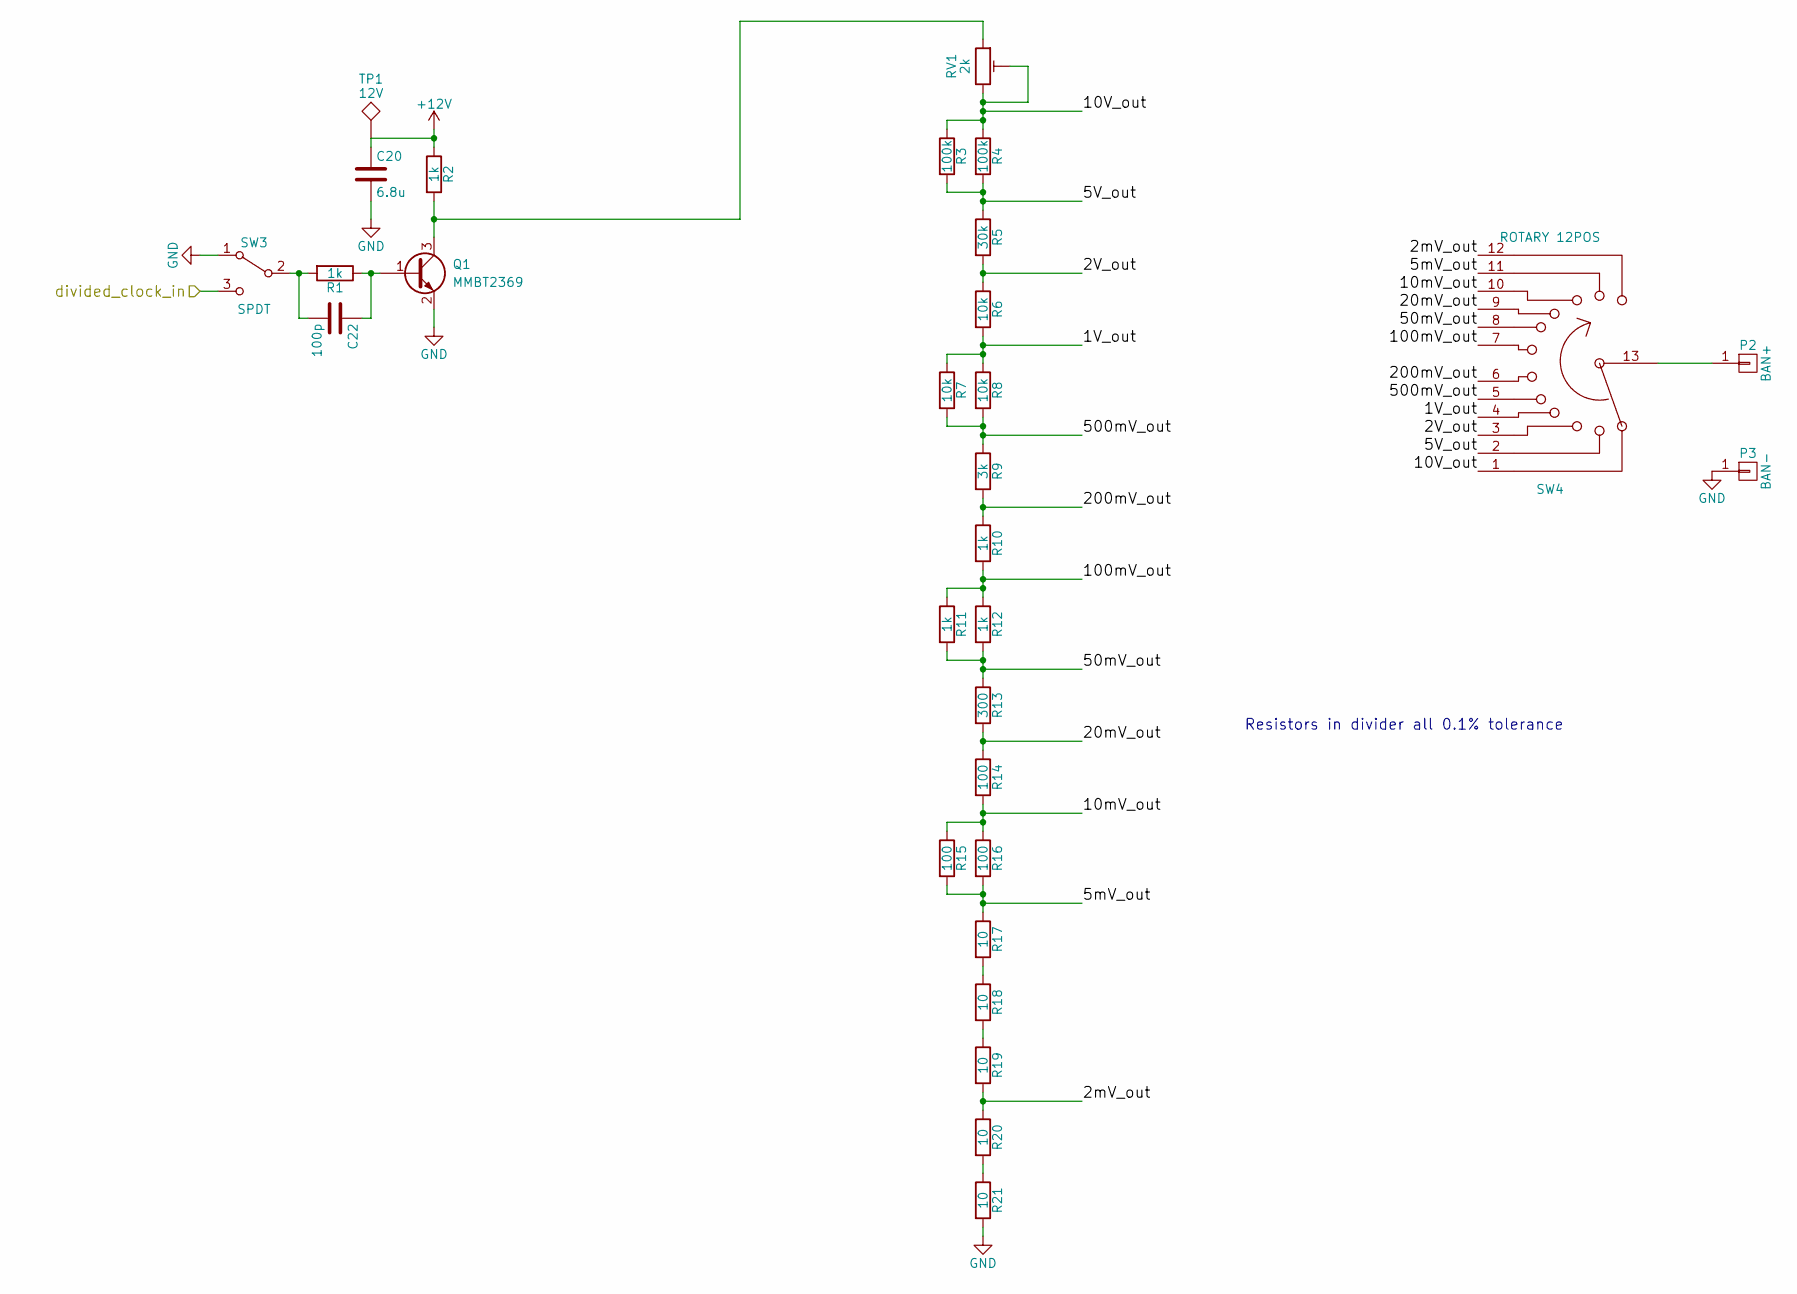
[picture p22: schematic voltage_output.sch, calbox voltage output]

Parts:
C20: 6.8u; C_0805_HandSoldering
C22: 100p; C_0805_HandSoldering
P2: BAN+; Pin_Header_Straight_1x01
P3: BAN-; Pin_Header_Straight_1x01
Q1: MMBT2369; SOT-23_Handsoldering; Manufacturer PN MMBT2369ALT1G
R1, R2, R10, R11, R12: 1k; R_0805_HandSoldering
R3, R4: 100k; R_0805_HandSoldering
R5: 30k; R_0805_HandSoldering
R6, R7, R8: 10k; R_0805_HandSoldering
R9: 3k; R_0805_HandSoldering
R13: 300; R_0805_HandSoldering
R14, R15, R16: 100; R_0805_HandSoldering
R17, R18, R19, R20, R21: 10; R_0805_HandSoldering
RV1: 2k; Potentiometer_Bourns_3362_ScrewUp; Manufacturer PN 3362P-1-202LF
SW3: SPDT; SW_SPDT_NKK_M201xxxx03; Manufacturer PN M2012SS1W03
SW4: ROTARY 12POS; SW_ROTARY_SP12T_MRK112; Manufacturer PN MRK112-A
TP1: 12V; Measurement_Point_Square-TH_Big

Connections:
+12V: C20.1, R2.1, TP1.1; also elsewhere on the board
/clock_final_division/clock_final_division_out: SW3.3 (C); also elsewhere on the board
/voltage_output/1V_out: R6.2, R7.1, R8.1, SW4.4
/voltage_output/2V_out: R5.2, R6.1, SW4.3
/voltage_output/2mV_out: R19.2, R20.1, SW4.12
/voltage_output/5V_out: R3.2, R4.2, R5.1, SW4.2
/voltage_output/5mV_out: R15.2, R16.2, R17.1, SW4.11
/voltage_output/10V_out: R3.1, R4.1, RV1.2, RV1.3, SW4.1
/voltage_output/10mV_out: R14.2, R15.1, R16.1, SW4.10
/voltage_output/20mV_out: R13.2, R14.1, SW4.9
/voltage_output/50mV_out: R11.2, R12.2, R13.1, SW4.8
/voltage_output/100mV_out: R10.2, R11.1, R12.1, SW4.7
/voltage_output/200mV_out: R9.2, R10.1, SW4.6
/voltage_output/500mV_out: R7.2, R8.2, R9.1, SW4.5
GND: C20.2, P3.1, Q1.2 (E), R21.2, SW3.1 (A); also elsewhere on the board
unnamed: C22.1, Q1.1 (B), R1.1
unnamed: C22.2, R1.2, SW3.2 (B)
unnamed: P2.1, SW4.13
unnamed: Q1.3 (C), R2.2, RV1.1
unnamed: R17.2, R18.1
unnamed: R18.2, R19.1
unnamed: R20.2, R21.1

Notes on the sheet:
Resistors in divider all 0.1% tolerance

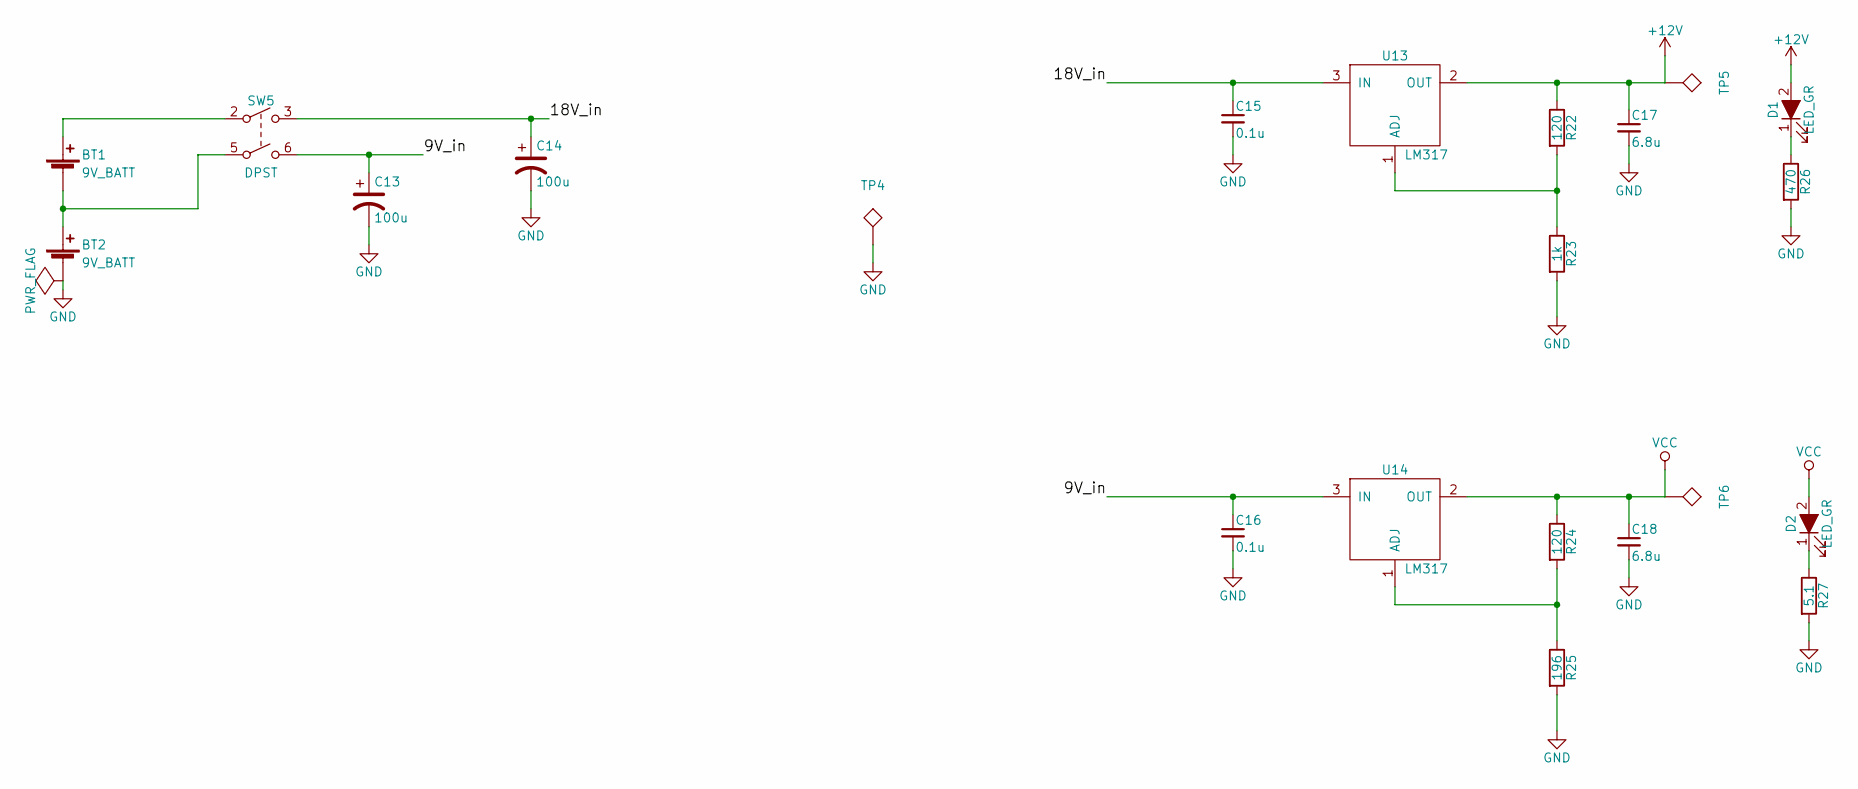
[picture p23: schematic power.sch, calbox power supply]

Parts:
BT1, BT2: 9V_BATT; battery_snap
C13, C14: 100u; C_Radial_D6.3_L11.2_P2.5; Manufacturer PN URS1E101MDD
C15, C16: 0.1u; C_0805_HandSoldering
C17, C18: 6.8u; C_0805_HandSoldering
D1, D2: LED_GR; LED-5MM; Manufacturer PN C503B-GCN-CY0C0792
R22, R24: 120; R_0805_HandSoldering
R23: 1k; R_0805_HandSoldering
R25: 196; R_0805_HandSoldering
R26: 470; R_0805_HandSoldering
R27: 5.1; R_0805_HandSoldering
SW5: DPST; SW_NKK_M20xxxxx03_DPST; Manufacturer PN M2021SS1W03
TP4: GND; Measurement_Point_Square-TH_Big
TP5: 12V; Measurement_Point_Square-TH_Big
TP6: 3.3V; Measurement_Point_Square-TH_Big
U13, U14: LM317; SOT-223; Manufacturer PN LM317DCYR

Connections:
+12V: C17.1, D1.2 (A), R22.1, TP5.1, U13.2 (OUT), U13.4 (OUT); also elsewhere on the board
/power/9V_in: C13.1, C16.1, SW5.6, U14.3 (IN)
/power/18V_in: C14.1, C15.1, SW5.3, U13.3 (IN)
GND: BT2.2 (-), C13.2, C14.2, C15.2, C16.2, C17.2, C18.2, R23.2, R25.2, R26.2, R27.2, TP4.1; also elsewhere on the board
unnamed: BT1.1 (+), SW5.2
unnamed: BT1.2 (-), BT2.1 (+), SW5.5
unnamed: D1.1 (K), R26.1
unnamed: D2.1 (K), R27.1
unnamed: R22.2, R23.1, U13.1 (ADJ)
unnamed: R24.2, R25.1, U14.1 (ADJ)
VCC: C18.1, D2.2 (A), R24.1, TP6.1, U14.2 (OUT), U14.4 (OUT); also elsewhere on the board

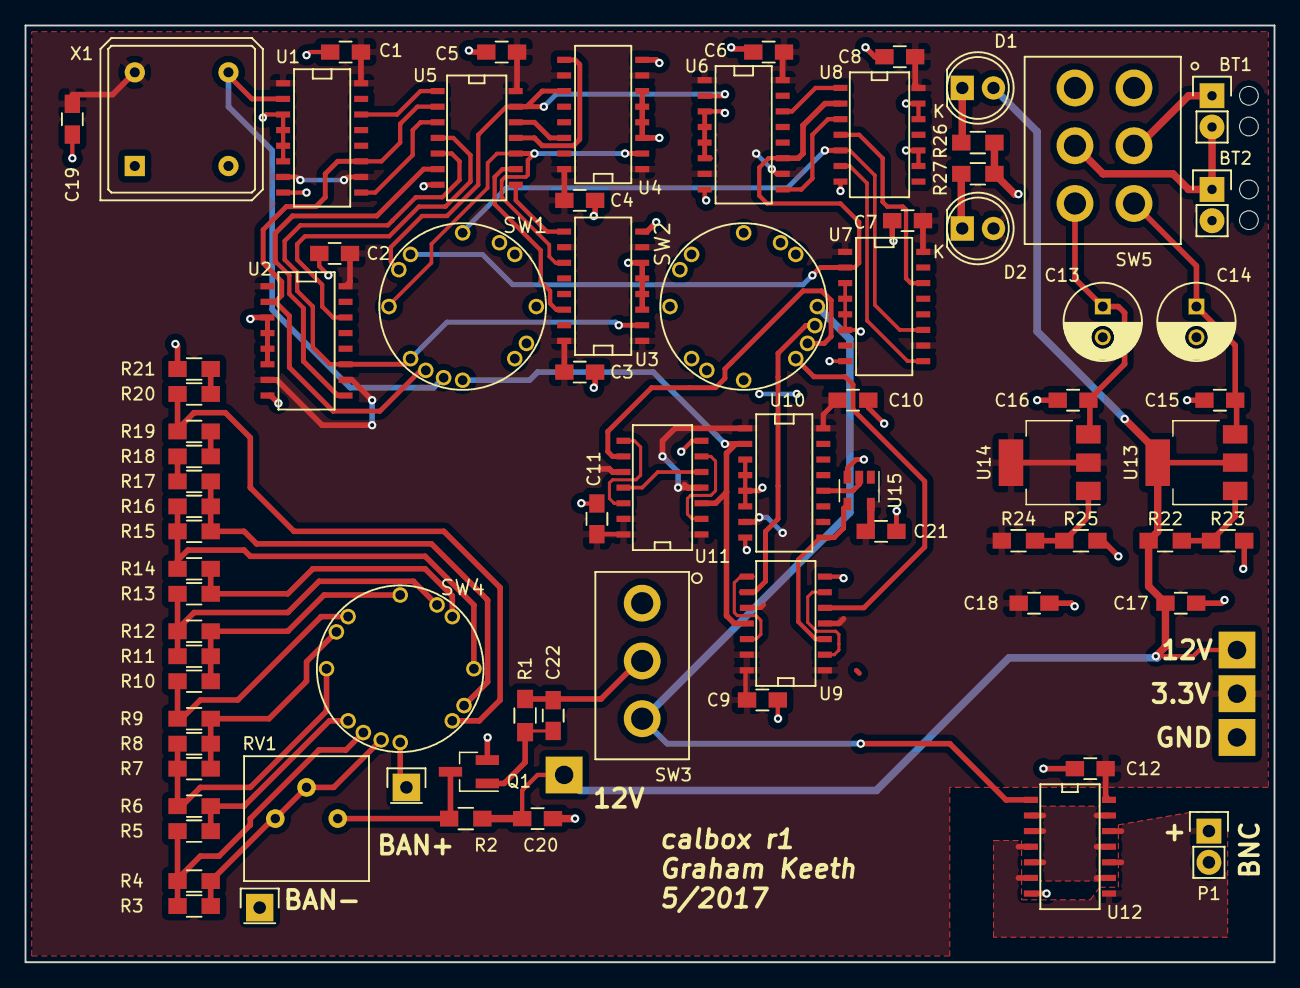
[picture p24: board calbox.kicad_pcb from above]

Board: 2 copper layers, 101.6 x 76.2 mm, 83 parts (0 on the bottom side), 63 nets.
