gkeeth/calbox/(commit log)

2017-03-16 Initial content commit. Schematic nearly finished; needs resistor divider values, a bypass cap on +12V, and test points. Layout r1 finished.
    [_saved_divide_by_10.sch, calbox.kicad_pcb, calbox.sch, clock_decade_division.sch, clock_final_division.sch, power.sch, time_output.sch, voltage_output.sch]
2017-03-16 Ignore *.kicad_pcb-bak files
2017-03-16 Added bypass capacitor to +12V line
    [calbox.kicad_pcb]
2017-03-16 Added testpoints for VCC, 12V, and GND
    [calbox.kicad_pcb, power.sch, voltage_output.sch]
2017-03-16 Added first pass of script to calculate optimum resistor values for voltage output divider
2017-03-18 Updated voltage output divider to use practical resistor values
    [calbox.kicad_pcb, calbox.sch, clock_decade_division.sch, clock_final_division.sch, power.sch, time_output.sch, voltage_output.sch]
2017-03-19 R2 PCB rotary switches closer to middle of board
    [calbox.kicad_pcb, calbox.sch, calbox_BOM.csv, clock_decade_division.sch, clock_final_division.sch, power.sch, time_output.sch, voltage_output.sch]
2017-03-26 update switch models in library, rotate final clock division switch
    [calbox.kicad_pcb, calbox_BOM.csv, calbox_BOM.xlsx, clock_decade_division.sch, clock_final_division.sch, power.sch, voltage_output.sch]
2017-03-26 add dimensions to pcb
    [calbox.kicad_pcb]
2017-03-26 updated layout, specifically banana plug attachment points
    [calbox.kicad_pcb]
2017-03-26 reorganize repo
    [calbox_BOM.csv, calbox_BOM.xlsx]
2017-03-26 version sent to EasyEDA 3/26/17
    [calbox-B.Cu.gbl, calbox-B.Mask.gbs, calbox-Cmts.User.gbr, calbox-Dwgs.User.gbr, calbox-Eco1.User.gbr, calbox-Eco2.User.gbr, calbox-Edge.Cuts.gm1, calbox-F.CrtYd.gbr]
2017-04-17 Several schematic & layout changes after building first boards
    - increase current limiting resistors on LEDs to make them less blinding
    - add speedup cap, increase base resistor on voltage output switching
    transistor for better high frequency performance (should work up to 10MHz)
    - change switched/constant voltage output toggle switch to actually work
    (now toggles between switched voltage output and constant voltage
    output, rather than switched and 0V output)
    - add inverter to make div-by-5 circuit work
    [calbox-B.Cu.gbl, calbox-B.Mask.gbs, calbox-Cmts.User.gbr, calbox-Dwgs.User.gbr, calbox-Eco1.User.gbr, calbox-Eco2.User.gbr, calbox-Edge.Cuts.gm1, calbox-F.CrtYd.gbr]
2017-04-17 update layout for div-by-5 inverter
    [calbox.kicad_pcb]
2017-04-17 update voltage output schematic
    [voltage_output.sch]
2017-05-23 Add battery snap footprint with stress relief NPTHs
2017-05-23 Update schematic for rev1
    - add battery snap footprint
    - add speedup cap for voltage output transistor
    - correct voltage output toggle switch operation (vcc -> gnd for
    constant voltage output)
    - add single gate inverter for correct divide-by-10 operation
    [calbox.sch, clock_decade_division.sch, clock_final_division.sch, power.sch, time_output.sch, voltage_output.sch]
2017-05-23 Layout changes for r1
    [calbox.kicad_pcb]
2017-05-23 Update battery snap footprint NPTHs to be bigger and actually non-plated
2017-05-23 Updated layout, gerbers, and layout pdf for enlarged battery non-plated through holes
    [calbox-B.Cu.gbr, calbox-B.Mask.gbr, calbox-B.Mask.gbs, calbox-Edge.Cuts.gbr, calbox-Edge.Cuts.gm1, calbox-F.Cu.gbr, calbox-F.Fab.gbr, calbox-F.Mask.gbr]
2017-05-23 minor layout update
    [calbox.kicad_pcb]
2017-05-23 Update gerbers to not have sheet headers
    [calbox-B.Cu.gbr, calbox-B.Mask.gbr, calbox-Edge.Cuts.gbr, calbox-F.Cu.gbr, calbox-F.Mask.gbr, calbox-F.SilkS.gbr, calbox-NPTH.drl, calbox.drl]
2017-05-23 remove unnecessary fab drawing from gerbers
    [calbox-B.Cu.gbr, calbox-B.Mask.gbr, calbox-Edge.Cuts.gbr, calbox-F.Cu.gbr, calbox-F.Fab.gbr, calbox-F.Mask.gbr, calbox-F.SilkS.gbr, calbox-NPTH.drl]
2017-05-26 Update BOM and add formatted BOM
    [calbox_BOM.csv, calbox_BOM_fmt.csv]
2017-07-03 update dimensions for LED holes in case
